enyyaalark/px4-dual-motor-rpm-sync/data/raw/2026-09-03/2026-09-03_ch2_hc14_manual_1nF.png

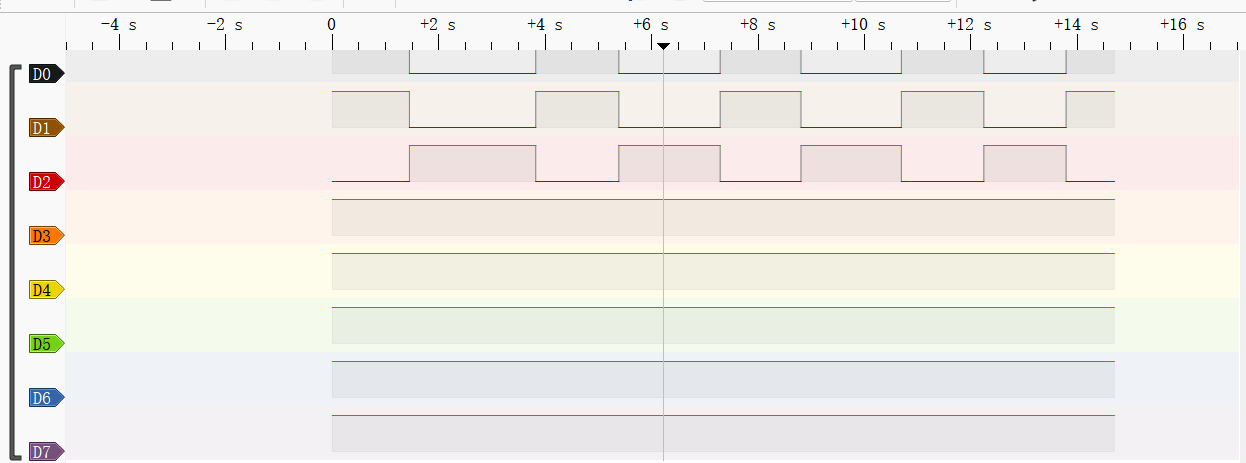
data/raw/2026-09-03/2026-09-03_ch2_hc14_manual_1nF.png
