enyyaalark/px4-dual-motor-rpm-sync/data/raw/2026-09-03/2026-09-03_crosstalk_both_same.png

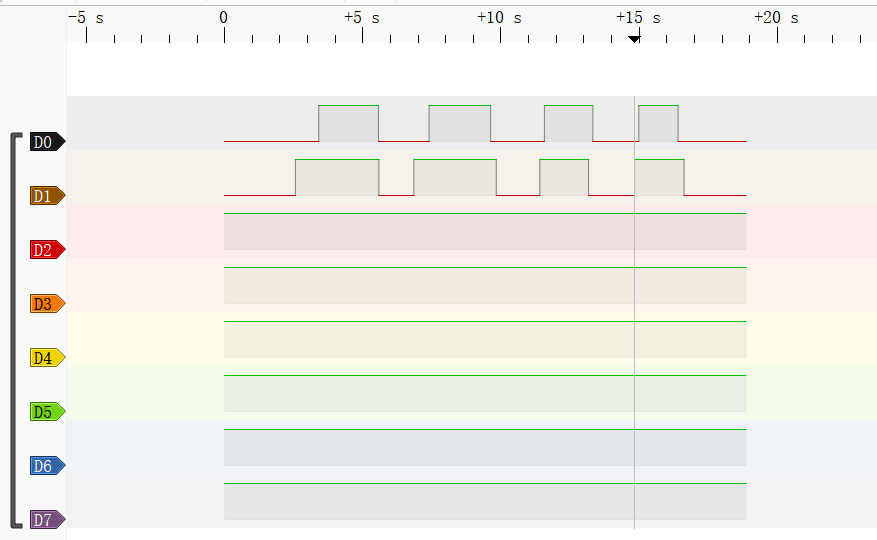
data/raw/2026-09-03/2026-09-03_crosstalk_both_same.png
