enyyaalark/px4-dual-motor-rpm-sync/firmware/stm32/README.md

# STM32G431 固件骨架

此目录包含与硬件无关、可在主机上检查的 C++17 应用层、Issue #3 的最小点灯/UART 工程、Issue #6 的双路霍尔捕获、Issue #9 的双路 PX4 PWM 输入，以及 Issue #10 的 TIM1 双路 PWM 输出。Hall 捕获已实机验证；PWM 输入已实机静态采集；TIM1 输出已通过 CubeMX 重新生成和 Debug/Release 目标构建，但尚未接逻辑分析仪实机验证。旁路和最终整机落针仍未验证，当前工程不能作为最终控制器配置。

`rpm_sync_bringup.ioc` 是 Issue #3 专用的最小点灯/UART 配置，不是最终控制器引脚表。它只使用经 WeAct Studio V1.0 原理图和官方示例确认的板级资源：QFN48 `STM32G431CBU6`、`PC6` 用户 LED、`PA13/PA14` SWD，以及 STM32 数据手册支持的 `PA9/PA10` USART1。后续霍尔、PWM、旁路和 DMA 分配仍保持 `TBD`。

Issue #10 已把双路 PWM 校验通过 `pwm_output_adapter.h` 暴露给生成的 C/HAL 层，并把
实现链接进目标工程。按成员 A 2026-09-14 的配置同步，`rpm_sync_capture.ioc` 现在把
`PA8/TIM1_CH1` 和 `PA10/TIM1_CH3` 配置为 1 MHz（Prescaler 15）、Period 2499（400 Hz）、
PWM mode 1、Active High、ARR/OC preload，初始 Pulse 为 0；`PA10` 不再作为 USART1_RX，
未接线的 `USART1_RX` 移到 `PB7`。`main.c` 提供一个仅逻辑分析仪使用的测试入口，
显式输出约 1000 µs（CH1）和 1080 µs（CH3），不接 ESC/HCT157/电机/电池，闭环保持关闭。

Issue #11 在同一工程中把 `PB2` 配置为 `BYPASS_SELECT` GPIO 输出（push-pull、no pull、
low speed）。`MX_GPIO_Init()` 会先写输出锁存低电平再初始化，确保上电/复位期间不产生
短高脉冲，外部 `10kΩ` 下拉继续保证 STM32 掉电/高阻时 HCT157 选择 PX4 A。测试固件
默认不自动选择 B；`BYPASS_SELECT_TEST_ENABLE` 默认为 `0U`，置 `1` 后才周期切换 PB2。

`rpm_sync_capture.ioc` 在该基线上加入 Issue #6 候选捕获：`PA0/TIM2_CH1` 和 `PA1/TIM2_CH2` 共用 1 MHz、32 位自由运行计数器，双路均为上升沿直接输入、中断捕获。数字滤波暂为 `0`，必须根据 HC14 实际波形和最高预期频率再确定。`hall_capture.c` 的中断路径只记录捕获 tick、周期和毫秒时间戳；主循环快照经 `rpm_evaluator.cpp` 薄适配层交给 C++17 的 `hall_monitor`，每秒通过 PA9 输出一次 `rpm_sync_capture,v2` 遥测，包含两路有效标志、周期（µs）、最后脉冲年龄（ms）、原始/有效 RPM 和状态。

Issue #9 在同一工程中加入 `PB4/TIM3_CH1` 和 `PB6/TIM4_CH1`。每路使用独立的 1 MHz、16 位 PWM-input/reset 定时器：CH1 捕获上升沿周期，CH2 间接捕获下降沿高电平宽度。ISR 只保存固定大小快照；主循环通过 `pwm_input_evaluator.cpp` 判断 950–1950 µs 范围和 10 ms 超时，并另发 `rpm_sync_pwm_input,v1` 诊断行，不改变现有 Hall v2 或 11 字段遥测协议。闭环仍关闭。MAIN1 实机发现 PA6 捕获接触不良，已于 2026-09-15 改为 PB4/TIM3_CH1。

实机接线复核后可做有界采集：`python3 tools/check_pwm_input_uart.py --port <本机串口> --duration-s 30 --required-samples 10 --require-both-valid --output data/raw/<日期>/<新文件名>.txt`。工具只接受新文件名，防止覆盖原始数据。串口设备名和本机绝对路径不得提交。

2026-09-10 的两电机三点标定已把 PPR 确认为 `1` 并更新集中配置。团队随后把
`kHallTimeoutMs=100U` 和 `kMaximumRpm=3300.0F` 接受为 `MONITOR_ONLY` 实机复核所需
的工程初值：前者来自 34.787 ms 最长入选周期，后者在 3000 RPM 台架安全上限之上
保留 10% 判定余量。当前构建因此可产生 `VALID`、`TIMED_OUT` 或
`IMPLAUSIBLE_PULSE`；这不代表停止归零或过速边界已实机验证，也不允许超过
3000 RPM 测试。闭环继续默认关闭，PWM 输出配置仍无效。

2026-09-11 将 `main` 提交 `67e07c3` 的 Release 构建经三线 SWD 写入并校验后，
`rpm_sync_capture,v2` 在 PA0/PA1 双路同时旋转时持续报告 `VALID`，停转后的下一秒
UART 快照起双路均报告 `TIMED_OUT`，且 raw/effective RPM 均为 0。原始记录见
`data/raw/2026-09-11/`。由于遥测周期为 1 秒，该证据不能测量精确的 100 ms 转换时刻；
100/101 ms 软件边界仍由主机测试覆盖。测试指令、电池当次电压和固定细节未写入原始
UART，完整 L2 条件复现仍需补充记录。

接线完成后，可用 `tools/check_hall_capture_uart.py` 做有界采集。工具兼容历史 `v1` 周期记录，并严格检查 `v2` 的 RPM/状态字段、无符号 32 位范围和有效标志；它以独占创建方式保存原始文本，避免覆盖已有证据。例如：`python3 tools/check_hall_capture_uart.py --port <本机串口> --duration-s 15 --required-samples 5 --require-both-valid --output data/raw/<日期>/<新文件名>.txt`。串口设备名只在本地命令中填写，不提交到仓库。

## 计划结构

```text
firmware/stm32/
├── App/                         C++17 应用接口与纯逻辑骨架
├── rpm_sync_bringup.ioc         Issue #3 最小点灯/UART 配置
├── rpm_sync_capture.ioc         Issue #6 双路 Hall 捕获候选配置
├── Inc/                         CubeMX 生成的初始化头文件
├── Src/                         CubeMX 生成的初始化源码和启动心跳
├── Drivers/                     STM32CubeG4 v1.6.3 所需 HAL/CMSIS 子集
├── STM32CubeIDE/                IDE 工程、启动文件和链接脚本
├── README.md
└── hardware_config_template.md
```

## 集成原则

1. 先在独立最小工程验证点灯、UART、双路捕获。
2. CubeMX 生成的 HAL/Core 可以保留 C；在薄的 `.cpp` 适配层中实现回调，必要时用 `extern "C"` 导出 HAL 要求的符号。
3. HAL 回调只采集时间戳/数据，计算和控制放在周期任务。
4. 所有引脚、定时器实例和 DMA 通道放在板级配置层，不写入通用模块。
5. `app_config.hpp` 中的默认值不会启用闭环；PPR、增益和超时必须标定。
6. 每个模块通过逻辑分析仪/主机测试独立验收后再集成。

主机语法检查：

```bash
c++ -std=c++17 -Wall -Wextra -Werror -fsyntax-only firmware/stm32/App/*.cpp
```

此命令不等同于 arm-none-eabi-g++ 交叉编译或 STM32 实机测试。嵌入式构建建议关闭 RTTI 和异常，但需在生成工程后通过尺寸与行为验证再固定编译选项。

## 点灯与 UART 启动前检查

先检查 CubeMX、CubeIDE、交叉编译器、下载器和调试器是否可发现：

```bash
python3 tools/check_stm32_toolchain.py
```

脚本会同时检查 `PATH` 和 STM32CubeIDE 的标准 Linux 安装目录。默认不打印本机绝对路径；`--show-paths` 只用于本地诊断，输出不得复制到仓库、Issue 或测试记录。

当前最小工程固定使用：

- WeAct Studio STM32G431 QFN48 V1.0、`STM32G431CBU6`；
- HSI 16 MHz、`PC6` 状态灯、`PA9/USART1_TX`、115200 8N1；
- STM32CubeMX 6.18.1、STM32CubeG4 v1.6.3、STM32CubeIDE 工程；
- 每 500 ms 翻转 LED，每 1 s 发送 `rpm_sync_bringup,v1,...,mode=MONITOR_ONLY`。

在 STM32CubeIDE 中导入 `firmware/stm32/STM32CubeIDE`。重新生成前必须安装 STM32CubeG4 v1.6.3，并选择只复制所需库文件；不得把本机固件包绝对路径写入 `.ioc`。

`Debug` 和 `Release` 两个 configuration 均已启用 `convertbinary`，构建后除 `.elf` 还产出 `.bin`。USB DFU 下载只接受 `.bin`，因此该选项不能关闭；`tests/test_stm32_bringup_config.py` 对此有回归测试，防止重新生成工程时被覆盖。DFU 下载使用 `Release/rpm_sync_bringup.bin`。

无图形界面时可用 headless 构建：

```bash
/path/to/stm32cubeide/headless-build.sh -data <临时工作区> \
  -importAll firmware/stm32/STM32CubeIDE -cleanBuild all
```

临时工作区不要放在仓库内。`Debug/`、`Release/`、`*.elf`、`*.bin` 已被 `.gitignore` 覆盖。

UART 仅允许单向连接：核心板 `PA9` 接 CH340 模块 `RXD`，两者 `GND` 相连。已测得 CH340 `TXD` 空闲电平约 5 V，因此 `TXD`、`5V`、`3V3`、`RTS`、`CTS` 均不得连接核心板。

本实板已于 2026-09-01 确认可通过核心板 USB-C 进入 STM32 ROM DFU，并使用 STM32CubeProgrammer 完成固件写入和校验。PC6 LED 的 500 ms 翻转已通过复位启动及 USB-C 断电重启观察。PA9 单向 UART 首次采集和 USB-C 断电约 5 秒后的第二次采集均获得至少 3 条完整、格式匹配的心跳；另外 30 秒连续采集获得 10/10 条有效心跳。Issue #48 于 2026-09-04 完成三线 SWD 只读验证：两次目标识别结果一致，断开 ST-LINK 后原点灯固件正常恢复；未执行擦除、下载或选项字节修改。2026-09-04 进一步经 ST-LINK 三线 SWD 下载并校验双路捕获固件（`Release/rpm_sync_bringup.bin`，SHA256 `c1ac5a01951ab47918bd1fad62f2dbb64dbaeb6adb38390f1267d37d5af36c98`），随后通过 UART 记录无脉冲、Hall 1、Hall 2 与复位后双路捕获；原始记录见 `data/raw/2026-09-04/`。`chN_valid` 是历史捕获标志，`chN_age_ms` 变化才表示新脉冲。

点灯与 UART 属于 L1 测试：电机主电源必须断开，螺旋桨必须拆除，并避免 USB、ST-LINK 和外部电源之间反灌。
