enyyaalark/px4-dual-motor-rpm-sync/docs/control-algorithm.md

# 控制算法

## PWM 输入有效性

输入捕获/中断层只记录最新原始脉宽、更新时间和“已有样本”标志。范围判断和超时判断在周期任务使用一致的数据快照完成，不在捕获路径写死尚未测量的 PX4 输入参数。

`pwm_input` 的纯逻辑接口由调用方提供最小脉宽、最大脉宽和超时。2026-09-11 已测得 PX4 MAIN1/2 为 400 Hz，静态 1000 µs、测试指令 1300 µs，配置端点为 disarmed 1000 µs、active 1100–1900 µs。因此 `app_config.hpp` 采用 950–1950 µs 监测窗口和 10 ms 超时（约四个丢失帧）作为 `MONITOR_ONLY` 实机验证初值。它不启用闭环，也不替代 STM32 实机捕获、PWM 电平和 ESC 范围验证。状态包括：

- `kWaitingForSample`：尚未捕获输入，有效脉宽为 0；
- `kValid`：样本未超时且位于调用方提供的闭区间内；
- `kTimedOut`：样本已过期，有效脉宽为 0；
- `kOutOfRange`：原始脉宽越界，有效脉宽为 0，但保留原始值供诊断；
- `kInvalidConfig`：最小值为 0、最小值大于最大值或超时为 0，拒绝输出。

毫秒时间使用无符号 32 位差值，可处理两次检查间最多一次回绕。主机测试证明状态语义，不证明 STM32 捕获精度或信号电平；若实机结果不满足当前窗口或超时，必须根据原始证据重新评审参数。

## PWM 输出有效性与最终限幅

`pwm_output` 的硬件无关接口同时接收两路浮点脉宽请求和调用方提供的最小/最大输出边界。当前 `app_config.hpp` 使用成员 A 2026-09-15 v2 台架范围 `1060–1080µs`；该范围仅用于无桨双电机 RPM 同步验证，不得用于飞行或带桨测试。

- 有限请求在闭区间内取到最近的整数微秒；超出边界时饱和到最近边界，并单独报告每路是否发生限幅；
- 最小值为 0 或最小值大于最大值时返回 `kInvalidConfig`；
- 任一路请求为 NaN 或无穷值时返回 `kInvalidRequest`，整组两路输出均不可用，避免只更新一侧；
- 返回状态不是 `kValid` 时，两路有效脉宽保持 0。未来 HAL 适配层必须检查状态并保持定时器输出未启用，不能把 0 当作已验证的 ESC 指令。

该接口只验证数值边界，不产生波形。输出频率、计数器换算、同步更新、启动/复位瞬态和真实限幅仍需逻辑分析仪完成 T07。

## RPM 计算

```text
RPM = 60 * pulse_frequency_hz / pulses_per_revolution
```

`pulses_per_revolution` 必须用激光转速计或其他独立方法标定，不根据磁极数量猜测。停止超时后 RPM 必须归零。

建议同时保留原始周期、瞬时 RPM 和经明确时间常数滤波后的控制 RPM。滤波不能掩盖脉冲丢失。

### 硬件无关计算状态

`rpm_capture` 用无符号 32 位减法计算相邻捕获值的差，可处理相邻脉冲之间最多一次计时器回绕。首个脉冲只建立基准，不产生周期或 RPM；脉冲时间戳是否存在由独立布尔状态表示，因此系统启动后 `now_ms == 0` 仍是合法时间。

`hall_monitor` 的纯逻辑接口由调用方传入计时器频率、PPR、停止超时和最大合理 RPM。
PPR 已于 2026-09-10 标定为 1；团队同时接受 `100 ms` 停止超时和 `3300 RPM` 最大
合理值作为 `MONITOR_ONLY` 复核初值。100 ms 来自 34.787 ms 最长入选周期，3300 RPM
是在 3000 RPM 硬件测试安全上限之上的 10% 异常判定余量；两者尚未实机验证，且
3300 RPM 不提高台架许可转速。任一必需参数为零值、负值、NaN 或无穷值都属于无效
配置，不能输出有效 RPM。计算结果分为：

- `kWaitingForPeriod`：尚无两个脉冲，有效 RPM 为 0；
- `kValid`：原始 RPM 在调用方提供的合理范围内，可用 RPM 等于原始 RPM；
- `kTimedOut`：最后脉冲超过调用方提供的超时，有效 RPM 和原始 RPM 均为 0；
- `kInvalidConfig`：PPR 等配置无效，拒绝输出；
- `kImplausiblePulse`：周期为零、计算失败或超过调用方提供的最大 RPM，有效 RPM 为 0；若公式可计算则保留 `raw_rpm` 供诊断。

Issue #7 已通过 C/C++ 薄适配层把这些状态接入双路 HAL 捕获快照和版本化 UART 遥测，但尚未接入最终故障标志或控制状态机。当前最大 RPM 与停止超时只是团队接受的待验证初值；脉冲跳变阈值、停止归零和双路行为仍必须用实测波形/UART 确认，主机测试不能代替该验证。

`system_controller` 已把上述模块组合成硬件无关周期步骤：MAIN1/MAIN2 两路基础 PWM 均有效、脉宽差不超过 `kBasePwmMismatchUs=20µs`、且两路都不低于台架输出下界 `1060µs` 时，才允许产生修正输出并选择 STM32 路径；任一输入等待、越界、单路超时、两路不一致或 disarm 基础值低于 1060µs 时继续选择 PX4 原始旁路。非同步状态只透传基础指令，`SYNC_CONTROL` 才施加受限修正。故障刷新目前使用非锁存活动故障；安全关键故障是否锁存以及 `kOutputSaturated` 的门控语义仍待故障注入实验后确定。

## 误差

第一阶段仅在 `base_pwm1 == base_pwm2`（允许小容差）时验证同步：

```text
error_rpm = rpm1 - rpm2
mean_rpm = (rpm1 + rpm2) / 2
error_percent = abs(error_rpm) / mean_rpm * 100
```

`mean_rpm` 过低时不计算百分比并禁止闭环，防止除零和低速噪声放大。

## P/可选 PI/可选滤波微分控制

```text
raw_error = rpm1 - rpm2
if raw_error > deadband_rpm:
    error = raw_error - deadband_rpm
elif raw_error < -deadband_rpm:
    error = raw_error + deadband_rpm
else:
    error = 0

filtered_error = lowpass(error, tau)         # tau <= 0 时跳过滤波
derivative = (filtered_error - previous_filtered_error) / dt

integral = clamp(integral + error * dt, integral_min, integral_max)
correction = clamp(Kp * filtered_error + Ki * integral + Kd * derivative,
                   -correction_limit_us, correction_limit_us)

pwm1 = clamp(base_pwm - correction, pwm_min_us, pwm_max_us)
pwm2 = clamp(base_pwm + correction, pwm_min_us, pwm_max_us)
```

- 死区使用“偏移补偿”而不是硬清零：越过边界后按 `raw_error - deadband_rpm` 计算，使输出在死区边界连续，减少边界抖振和过冲。
- 误差进入死区时清除滤波与积分状态，避免残留偏置把输出继续推过目标；误差换向时用当前误差重置滤波并抑制首拍微分冲击。
- 新增可选的一阶误差低通 `filter_tau_seconds` 和微分增益 `Kd`。`Kd=0` 且 `filter_tau_seconds<=0` 时退化为原有 P/PI 行为。
- 微分基于滤波后的误差做后向差分，并在首次有效采样时不输出微分项，避免使能瞬间的微分冲击。
- 当前拆桨台架参数为 `Kp=0.01`、`Ki=0`、`Kd=0.002`、`filter_tau_seconds=0.1`。本地 A/B 记录显示误差下降，但 baseline 仍含 UART 损坏字节，参数继续视为实验值，不代表飞行配置或最终标定结果；闭环使能策略仍默认关闭。
- P 控制先行；只有开环基线和 P 控制数据表明存在稳定残差且无振荡时才启用 `Ki`。条件积分抗饱和逻辑保持不变，输出饱和且误差同向时冻结积分。

## 必需保护

- 修正量限制：初值不超过基础指令跨度约 5%，最终依数据调整。
- 最终 PWM 限幅：软件测试使用 1000–2000µs synthetic 向量；项目默认值保持无效，必须用实际电调校准替换后才可启用。
- RPM 死区和低速闭环禁止。
- 积分限幅；输出饱和或故障时冻结/回退积分。
- 霍尔脉冲超时、非物理跳变和双路不一致检测。
- PX4 PWM 丢失、越界或两个基础目标不一致时停止“等转速”同步。
- 任一电机疑似失效时不得通过不断抬高另一侧/故障侧输出追赶。
- 故障时清零修正，转入 `BYPASS` 或经评审的安全状态。

## 参数调整顺序

1. `Ki = 0`、修正限幅很小，记录开环数据。
2. 从低 `Kp` 开始阶梯增加，每次只改一个参数。
3. 检查稳态误差、1–2秒恢复目标、振荡、修正饱和和温升。
4. 只有 P 控制结果可重复后评估 PI。
5. 每次参数变更记录固件提交、测试条件和 CSV。

## 差动推力兼容

未来若 PX4 给出不同基础指令，控制目标必须保留上层要求的目标差值；第一阶段直接退出同步控制，而不是强制两侧 RPM 相等。
