enyyaalark/px4-dual-motor-rpm-sync/docs/pin-map.md

# 引脚映射（Issue #6 捕获 L1 UART 采集已验证，整机方案仍待验证）

Issue #6 的候选方案已通过成员 A 的 L0 排针可及性复核和 STM32CubeMX 6.18.1 生成检查。双路 Hall、双路 PX4 PWM 输入与双路 TIM1 PWM 输出配置已落入 `rpm_sync_capture.ioc`；PWM 输入已实机静态采集，PWM 输出仅通过 CubeMX 生成与 Debug/Release 目标构建、尚未接逻辑分析仪实机验证，旁路及最终整机落针仍须各自完成电气和实机验证，因此本表不代表完整控制器已经定版。

| 功能 | 方向 | 外部信号 | STM32 定时器/GPIO | 电气要求 | 状态 |
|---|---|---|---|---|---|
| Hall 1 capture | 输入 | 第一颗 HC14 `1Y` | `PA0 / AF1 / TIM2_CH1` | 3.3 V 整形输出；上升沿捕获 | L0 可及性、CubeMX、物理接线与 UART 采集已验证；最高实际频率待 Issue #8 验证 |
| Hall 2 capture | 输入 | 第二颗 HC14 `1Y` | `PA1 / AF1 / TIM2_CH2` | 3.3 V 整形输出；上升沿捕获 | L0 可及性、CubeMX、物理接线与 UART 采集已验证；最高实际频率待 Issue #8 验证 |
| PX4 PWM 1 | 输入 | Pixhawk MAIN1（左侧后推电机基础指令） | 已配置 `PB4 / AF2 / TIM3_CH1` | 400 Hz；监测范围 950–1950 µs；电平待测 | CubeMX/目标构建通过；实机双路捕获已通过 |
| PX4 PWM 2 | 输入 | Pixhawk MAIN2（右侧后推电机基础指令） | 已配置 `PB6 / AF2 / TIM4_CH1` | 400 Hz；监测范围 950–1950 µs；电平待测 | CubeMX/目标构建通过；排针与实机捕获待复核 |
| ESC PWM 1 | 输出 | HCT157 B1 | 已配置 `PA8 / AF6 / TIM1_CH1` | 400 Hz；当前无桨台架范围 1060–1080 µs | 待实机波形、电平和 HCT157/ESC 边界复核 |
| ESC PWM 2 | 输出 | HCT157 B2 | 已配置 `PA10 / AF6 / TIM1_CH3` | 400 Hz；当前无桨台架范围 1060–1080 µs | 待实机波形、电平和 HCT157/ESC 边界复核 |
| Bypass select | 输出 | HCT157 S | 已配置 `PB2 / GPIO / BYPASS_SELECT` | push-pull、no pull、low speed，初始低电平；外部 10kΩ 下拉 | 需逻辑分析仪验证上电/复位低电平与 B 选择 |
| Telemetry TX | 输出 | CH340 RXD（第一阶段） | `PA9 / USART1_TX` | 3.3V UART；仅单向连接 | Issue #3 bring-up 已实板验证，最终控制器待复核 |
| Telemetry RX | 输入 | 第一阶段不连接 | 已配置 `PB7 / AF7 / USART1_RX`（仅满足 CubeMX Asynchronous 模式，不接线） | CH340 TXD 实测 5 V，禁止直连 | 最终控制器只发不收；bring-up `.ioc` 保持原样 |
| Status LED | 输出 | 板载蓝色 LED | `PC6` | WeAct QFN48 V1.0，低速推挽输出 | Issue #3 bring-up 已确认 |

## 定时器资源与理由

| 定时器 | 候选用途 | 计数方案 | 设计理由 | 未验证项 |
|---|---|---|---|---|
| `TIM2` | Hall 1/2 上升沿捕获 | CubeMX 配置为 1 MHz 自由运行、32 位递增计数 | 两路共享同一时间基准；1 µs/tick 时约 71.6 分钟回绕，应用层按无符号 32 位差值处理单次回绕 | 实机 tick/波形对照、输入滤波、最大脉冲频率和中断负载 |
| `TIM3` | PX4 PWM 1 测量 | 已配置 1 MHz；PWM input/reset mode | 每路 PWM 独占一个定时器，避免两路信号争用同一 slave-reset 时间基准 | STM32 实机周期/脉宽、丢失和越界行为 |
| `TIM4` | PX4 PWM 2 测量 | 与 TIM3 相同 | 与 MAIN1 独立测量，可分别检测超时和越界 | 同上 |
| `TIM1` | ESC PWM 1/2 输出 | 已配置 1 MHz、Prescaler 15、Period 2499（400 Hz）；CH1/CH3 PWM mode 1、OC preload、ARR preload | 两路共享周期计数器并同步更新；当前无桨台架范围 1060–1080 µs | 启动/复位瞬态、输出电平、频率、脉宽和 HCT157 波形 |

## Issue #6 实际 Hall 接线

成员 A 于 2026-09-03 更正确认：两路分别使用两颗独立 SN74HC14N 的第一组门，而不是在同一颗芯片上使用 `1A/1Y` 和 `2A/2Y`。

```text
第一颗 SN74HC14N：1A 接第一路 RC 输出，1Y -> PA0/TIM2_CH1
第二颗 SN74HC14N：1A 接第二路 RC 输出，1Y -> PA1/TIM2_CH2
```

两颗芯片的独立 RC 网络、3.3 V 供电、100 nF 退耦和共地已由成员 A 复核。门编号变化不改变 STM32 引脚或固件通道映射；双路捕获已通过 SWD 下载固件与 UART 采集验证。项目负责人取消单独的手动周期对照，最高预期频率与滤波结论转交 Issue #8。

`PA11/PA12` 保留给板载 USB/ROM DFU 路径，不用于控制输出；`PA13/PA14` 始终保留 SWD；`PA9` 保留单向遥测；`PC6` 保留状态灯。`PA10` 已改为 `TIM1_CH3`，未接线的 `USART1_RX` 移到 `PB7` 以保持 CubeMX Asynchronous 模式。这不授权连接 CH340 TXD 或任何 RX 线路。

## HAL 捕获边界

1. `HAL_TIM_IC_CaptureCallback` 或等效 IRQ 适配层只读取捕获寄存器、记录通道和时间戳，并调用有界的脉冲采集入口；不在中断中计算 RPM、判断故障、格式化 CSV 或发送 UART。
2. Hall 两通道读取同一 `TIM2` 32 位计数域；不得用毫秒系统时钟代替捕获 tick。应用层周期任务再调用 `evaluateRpm` 处理超时、异常和归零。
3. PX4 PWM 每路使用独立定时器测量周期和高电平宽度；根据 2026-09-11 的 400 Hz 波形，输入采用上升沿、无数字滤波、10 ms 监测超时。该初值只用于 `MONITOR_ONLY` 实机复核，实测失败时必须回退并重新评审。
4. 捕获数据从 IRQ 交给周期任务时必须使用固定大小快照和明确的临界区/原子策略；不得动态分配、阻塞或使用无界队列。
5. 首轮实机验证只允许 L1 手动脉冲或已复核的逻辑信号。电机主电源断开、螺旋桨拆除；逻辑分析仪物理接线和原始波形采集由成员 A 完成。

## 复核依据

- STMicroelectronics [`DS12589 Rev 6`](https://www.st.com/resource/en/datasheet/stm32g431cb.pdf)，STM32G431x6/x8/xB 数据手册 Table 12/13：封装引脚和 alternate function。
- STMicroelectronics [`RM0440 Rev 9`](https://www.st.com/resource/en/reference_manual/dm00355726.pdf)：`TIM2` 为 32 位通用定时器，`TIM3/TIM4` 为 16 位通用定时器；输入捕获、PWM input 和 preload/update 行为以该手册为准。
- WeAct Studio [`WeActStudio.STM32G431CoreBoard`](https://github.com/WeActStudio/WeActStudio.STM32G431CoreBoard) 官方仓库的 QFN48 V1.0 原理图：候选 GPIO 已引出到两侧排针；最终仍须成员 A 对实板丝印和可及性复核。

## 分配准则

1. 两路霍尔使用同一个 32 位自由运行时间基准，以保证跨通道周期差可直接比较。
2. 两路 PX4 PWM 捕获和两路 ESC PWM 输出避免通道/复用冲突。
3. 确认引脚为 3.3V 容限、上电状态安全且不占用 SWD。
4. 记录 CubeMX 版本、时钟树、计数频率和溢出处理策略。
5. 分配完成后由另一名成员对照原理图、数据手册和核心板丝印复核。

第一阶段固定使用 `MAIN1 -> 左侧后推电机`、`MAIN2 -> 右侧后推电机`，并只验证两路基础指令相同的同步。这里的编号从机体向前观察，以机体左/右为准；它只是逻辑通道基线。在确认 Pixhawk 硬件修订、输出电平、连接器方向并完成无动力波形验证前，不得据此连接 ESC。
