enyyaalark/px4-dual-motor-rpm-sync/docs/open-questions.md

# 待确认问题

未知项不得在代码或接线中猜测。确认后应附数据手册/测量证据，并同步更新相关文档。

| ID | 待确认项 | 为什么重要 | 负责人建议 | 阻塞内容 |
|---|---|---|---|---|
| Q01 | 飞控外壳已确认 `Pixhawk 6C Mini`；制造商和 Model A/B/legacy 硬件修订仍待确认 | 修订决定 PWM 电压选择位置和部分硬件能力 | role:hardware | PWM 电平确认与最终接线 |
| Q02 | PX4 已更新为 1.17.0（提交 `d6f12ad1c4f70ad3230afd7d86e971421e02fef4`）；`SYS_AUTOSTART=2100`、`SYS_HITL=0`、MAIN1/2=Motor1/2，但双发几何和最终飞行配置仍未验收 | 参数名、输出协议和行为必须绑定精确版本；台架通道成立不等于飞行配置安全 | role:firmware | 最终 PX4 配置与飞行前评审 |
| Q03 | 接收机已确认 FlySky `FS-SR8`（用户 2026-09-02 确认；旧照片识读 FS-iA10B 有误），厂家资料为 2.4GHz ANT 协议、输出可选 PWM/PPM/i-BUS/s-BUS；当前实际输出模式仍待确认（不能由型号推断） | 决定 PX4 输入配置 | role:hardware | 遥控全链路 |
| Q04 | 两只 ESC 已确认为相同的 Flycolor `Raptor5 G071-35A`，固件标识均为 `Flycolor_Raptor_5`（用户确认）；固件版本号、配置、3.3V 接受度和失联行为仍待确认 | 决定 PWM 范围、刷新率和安全行为 | role:hardware | PWM 输出/安全 |
| Q05 | 电池已确认为 3S1P，用户确认额定 11.1V、4000mAh、100C；化学体系、满充/当前实测电压、连接器和线规仍待确认 | 容量与 C 倍率共同决定理论电流；实测电压和连接决定动力风险与降压设计 | role:hardware | 带电机测试 |
| Q06 | 螺旋桨尺寸与旋向 | 决定负载和机械安全 | role:hardware | 带桨测试 |
| Q07 | Hall 捕获 `PA0/PA1 + TIM2_CH1/CH2` 已实机验证；PWM 输入 `PB4/TIM3_CH1 + PB6/TIM4_CH1` 已实机双路采集；TIM1 双路 PWM 输出 `PA8/TIM1_CH1 + PA10/TIM1_CH3` 已通过逻辑分析仪实机验证；旁路选择 `PB2/GPIO` 已配置为初始低电平、仅逻辑分析仪测试入口可切换。HCT157 旁路及最终整机资源仍待验证 | 决定完整 CubeMX 工程与布线 | role:firmware | HCT157 旁路与整机集成 |
| Q08 | 独立激光转速计型号/可用性 | PPR 和 3% 误差目标需要参考 | 两人共同 | M1 标定 |
| Q09 | HCT157/HC14 实物厂商与供电方案 | 电平阈值和绝对额定值必须按数据手册确认 | role:hardware | 逻辑电路上电 |
| Q10 | 刚性台架、防护罩和急停方案 | 带桨测试的前置安全条件 | 两人共同 | M3 带桨测试 |
| Q11 | CH340 USB-TTL 到 STM32 的电平转换方案 | 当前 TXD 空闲高电平实测为 5V，不能直连 STM32；T01 仅使用 STM32 TX 到 CH340 RX 的单向链路 | role:hardware | 双向 UART 或任何 CH340 TX 接入 |
| Q12 | 中央 `DIO/CLK/GND` SWD 排针及三线调试链路已验证 | 两侧 I/O 排针和中央 SWD 排针均已组装；两次只读 SWD 识别结果一致，断开后原点灯固件恢复正常 | 已确认 | 不再阻塞 SWD 调试；其他 I/O 仍需按最终引脚表逐项复核 |

## 决策记录模板

```text
问题 ID：
结论：
依据（数据手册/测量/照片）：
确认日期：
复核人：
受影响文件：
```

## 2026-09-01 部分确认记录

- Q01：用户确认现有临时照片展示飞控底面，可读到 `pixhawk 6c mini` 和 MAIN/AUX/RC IN 端口编号；但该底面没有可读的制造商、Model A/B/legacy 修订或 PWM 电压焊盘状态。Holybro 同型号资料显示 PWM 输出可能随硬件修订/焊盘配置为 3.3V 或 5V，因此在获得其他修订证据并实测前，不关闭电平相关问题。
- Q03：临时照片可读到 FlySky `FS-iA10B`；厂家规格列出 AFHDS 2A、10 路 PWM，以及 PWM/PPM/i.bus/s.bus 数据接口。照片不证明当前接收机配置。（2026-09-02 更正为 FS-SR8，见下方记录。）
- Q04：临时照片可读到 Flycolor Raptor 5、35A、3–6S；厂家产品页对应 `Raptor5 G071-35A`，厂家手册列出 35A 持续、40A/10秒、无 BEC、3–6S，并支持普通 1–2ms PWM。用户后续确认第二只 ESC 同型号；两只实际固件、配置和输入电平阈值仍需实物/测量证据。
- 临时照片文件名和厂家链接记录在 `docs/hardware-overview.md`；`Pictures/` 不进入版本控制。
- Q02：仅 USB 供电条件下通过 MAVLink 读取 PX4 v1.12.3；同时发现 `SYS_AUTOSTART=1001`、`SYS_HITL=0`、MAIN 1–4/400Hz/1075–1950us。用户已确认台架逻辑映射为 `MAIN1 -> 左侧后推`、`MAIN2 -> 右侧后推`，两路使用相同基础指令；但 PX4 v1.12 文档将 1001 定义为 HIL Quadcopter X，因此通道映射不解除动力测试阻塞。完整只读记录见 `docs/hardware-overview.md`。
- Q02（2026-09-11 当前基线）：NSH `ver all` 确认 PX4 1.17.0、提交 `d6f12ad1c4f70ad3230afd7d86e971421e02fef4`；`SYS_AUTOSTART=2100`、`SYS_HITL=0`、MAIN1/2 功能 101/102、400 Hz、disarmed 1000 µs、active 1100–1900 µs。成员 A 在 USB-only 条件下用逻辑分析仪确认双路 400 Hz/1000 µs，并分别通过 `actuator_test` 观察到目标通道 1300 µs、另一通道保持 1000 µs及约 500 ms ramp。该证据确认 Issue #9 的台架输入，不确认 PWM 电压或最终飞行几何。
- Q04/Q05/布局：用户确认验证结构为双发后推布局，两只 ESC 同型号，并提供电池 3S1P、11.1V、100C 信息。未提供容量，故不能计算 100C 对应的理论电流；动力测试继续等待电池标签/实测与电气复核。（2026-09-02 用户补充确认容量 4000mAh，见下方记录。）

## 2026-09-02 确认/更正记录

- Q03（更正）：用户确认接收机一直为 FlySky `FS-SR8`，2026-09-01 依照片识读的 `FS-iA10B` 是错误识别。厂家官方资料（产品页与 FS-SR8 用户手册）：2.4GHz ANT 协议、8 通道 PWM、双天线、供电 3.5–9V、输出可选 PWM/PPM/i-BUS/s-BUS。遥控器（发射机）型号、接收机当前输出模式与输出电平仍待确认，不能由型号推断。复核：成员 B（PR #51 评审）。
- Q04：用户确认两只 Raptor5 G071-35A ESC 的固件标识均为 `Flycolor_Raptor_5`；固件版本号、配置参数、3.3V 控制电平接受度和失联行为仍需实物/测量证据。复核：成员 B（PR #51 评审）。
- Q05：用户补充确认电池容量 4000mAh，额定信息完整为 3S1P、11.1V、4000mAh、100C；化学体系、满充/当前实测电压、连接器和线规保持 `TBD`，等待电池标签照片与实测。复核：成员 B（PR #51 评审）。
- 上述确认记录于 PR #51 评审意见及 Issue #1/#2 评论；基线同步更新至 README、`docs/hardware-overview.md`、`docs/bill-of-materials.md`、`docs/open-questions.md`、`docs/voltage-interface-table.md` 与 CHANGELOG。

## 2026-09-03 确认记录

- Q12：用户确认核心板中央 `DIO/CLK/GND` SWD 排针已经焊接。成员 A 随后完成三线对应、无短路、单一供电与外围隔离复核；成员 B 于 2026-09-04 使用 STM32CubeProgrammer v2.23.0 连续两次只读识别到 3.27 V、Device ID `0x468`、STM32G43x/G44x、128 KBytes NVM 和 Cortex-M4。断电拆除 SWD 三线后，仅恢复 USB-C 供电，用户观察 PC6 点灯固件正常运行。未执行擦除、下载或选项字节修改，未记录探针序列号或芯片 UID；证据见 Issue #48。

## 2026-09-04 确认记录

- Q07/Q12：成员 B 于 2026-09-04 经 ST-LINK 三线 SWD 下载并校验双路捕获固件，随后通过 PA9 单向 UART 记录无脉冲、Hall 1、Hall 2 与复位后双路捕获，两路 `chN_valid` 均置位且周期非零。原始记录见 `data/raw/2026-09-04/`。项目负责人随后取消单独的手动周期对照并按修订范围关闭 Issue #6；PPR 标定、最高预期频率与数字滤波结论转交 Issue #8。
