enyyaalark/px4-dual-motor-rpm-sync/docs/voltage-interface-table.md

# 电压接口表

> 建立日期：2026-08-31
> 状态：A3144E→HC14 双路 L1 手动触发、串扰与线束稳定性验证已完成（独立第二颗 SN74HC14N 1A/1Y；限于 20 kHz 采样率、50 µs 时间分辨率与现有捕获窗口；1nF 保留为起始值）；STM32 定时器捕获已通过 SWD 下载固件与 UART 双路采集验证。单独的手动周期对照已取消，RPM 与最高预期脉冲频率验收转交 Issue #8
> 原则：未确认项保持 `TBD`，不猜测；每项确认都要附数据手册、照片或测量证据

## 表格

| 接口 | 发送端 | 发送端电平/协议 | 接收端 | 接收端要求 | 实测值 | 状态 | 证据 |
|---|---|---|---|---|---|---|---|
| PX4 -> STM32 PWM 输入 | Pixhawk 6C Mini，PX4 1.17.0（提交 `d6f12ad1c4f70ad3230afd7d86e971421e02fef4`） | 400 Hz 标准 PWM；信号电压可硬件切换 3.3V/5V | STM32G431 PB4/TIM3_CH1、PB6/TIM4_CH1 | 3.3V 容限 | 静态 1000 µs、动态 1300 µs，约 ±1 µs；电压 `TBD` | 时序/通道已测，电平和 STM32 实机捕获待确认 | Issue #9 NSH 与逻辑分析仪评论 |
| STM32 -> HCT157 | STM32G431 PWM 输出 | 3.3V PWM | SN74HCT157N B1/B2 | 输入高电平阈值按数据手册 | `TBD` | 待测 | 数据手册/逻辑波形 |
| HCT157 -> ESC | SN74HCT157N Y1/Y2 | 标准 PWM，暂定 1000–2000µs | Raptor 5 ESC，固件 `Flycolor_Raptor_5` | 支持常规 1–2ms PWM；3.3V 控制电平待实测 | `TBD` | 型号已确认，3.3V 接受度待实测 | Flycolor 说明书/实测 |
| A3144E -> HC14 | A3144E OUT，开集电极 | VCC 5.06V；OUT 经 4.7kΩ 上拉至 3.3V，1kΩ 串联，1nF 起始滤波 | SN74HC14N 施密特输入 | 施密特输入，3.3V 逻辑 | 无磁体：OUT 3.26V、1A 3.26V、1Y 0V；2 颗磁铁约 7mm 触发，单次边沿干净 | L1 手动触发实测通过 | 2026-09-02 波形与原始采集（`data/raw/2026-09-02/`，含 `.sr`）、万用表记录 |
| HC14 -> STM32 霍尔捕获 | SN74HC14N #1 `1Y` / 独立 #2 `1Y` | 3.3V 整形方波（反相） | STM32 TIM2 输入捕获候选 `PA0/PA1` | 定时器输入捕获能力 | 无磁体 0V，触发时约 3.2V；UART 双路捕获周期非零 | 输出端、接线与 UART 采集已验证；最高频率与数字滤波结论待 Issue #8 | 2026-09-02/03 波形（`data/raw/2026-09-02/`、`data/raw/2026-09-03/`，含 `.sr`）、2026-09-04 UART 原始记录（`data/raw/2026-09-04/`） |
| STM32 UART -> PC/PX4 | STM32G431 TX | 3.3V UART，波特率 `TBD` | USB-TTL RX / PX4 RX | RX 电平匹配 | `TBD` | 待测 | 串口记录 |
| 接收机 -> PX4 遥控输入 | FLYSKY FS-SR8（用户确认；2026-09-01 照片识读的 FS-iA10B 有误） | 2.4GHz ANT 协议；输出可选 PWM/PPM/i-BUS/s-BUS（厂家资料） | Pixhawk 6C Mini RC 输入 | 待确认实际输出模式；不能由型号推断 | `TBD` | 型号与协议能力已确认，实际输出模式待定 | FlySky 官方产品页/FS-SR8 手册（见参考来源） |
| 电池 -> ESC 主电源 | 3S1P 电池（用户确认 4000mAh），标称 11.1V，化学体系 `TBD` | 标称 11.1V 电压 | Raptor 5 ESC | 支持 3–6S | `TBD` | 电池额定信息已确认（用户），实际电压/连接待测 | 用户确认记录（PR #51 评审/Issue #1）、Flycolor 说明书 |
| 电池 -> 降压模块 -> 逻辑电源 | 电池，规格已记录 | 11.1V 标称电压 | 降压模块，型号 `TBD` | 输入额定范围 | `TBD` | `TBD` | 数据手册/万用表 |
| 降压模块 -> 逻辑电路 | 降压模块输出，型号 `TBD` | 输出电压 `TBD`，额定电流 `TBD` | STM32/HC14/HCT157 供电 | 3.3V 逻辑电源，纹波 `TBD` | `TBD` | `TBD` | 数据手册/万用表 |
| L1 逻辑电源（临时台面） | WeAct 板 3.3V / USB-TTL 5V | 3.26V / 5.06V | HC14/A3144E 供电 | 3.3V 逻辑、霍尔 5V | 3.26V / 5.06V | 实测通过，仅限 L1 临时电源，非最终降压方案 | 万用表记录 2026-09-02 |
| 共地 | PX4、STM32、HC14、HCT157、ESC 信号地 | GND | 所有控制信号共同参考地 | 共地 | L1 台面：WeAct、USB-TTL、HC14 共地已验证；PX4/ESC 共地待后续 | 部分验证 | 万用表/L1 接线记录 |

## 当前已从仓库确认的信息

- A3144E 输出为开集电极，按设计使用 `4.7kΩ` 上拉至 3.3V，`1kΩ` 串联，`1nF` 起始滤波，再进入 SN74HC14N。
- STM32G431 应用层按 3.3V 逻辑设计，UART 输出为 3.3V 电平。
- HCT157 暂定使用 STM32 的 3.3V PWM 作为 B 输入，默认选择 PX4 原始 PWM。

## 本次新增确认信息

- Pixhawk 6C Mini 的 PWM 输出支持 3.3V 和 5V 两种硬件切换模式，需要检查实际板子焊接了哪个电压。
- Raptor 5 ESC 支持常规 1–2ms 标准 PWM 输入，上电时自动检测输入协议。
- Raptor 5 ESC 支持 3–6S 电池（厂家手册）；3S1P、4000mAh、标称 11.1V 电池在额定范围内（电池化学体系未确认，不作为匹配依据）。
- FLYSKY FS-SR8 使用 2.4GHz ANT 协议，输出可选 PWM、PPM、i-BUS 和 s-BUS（厂家资料：官方产品页与 FS-SR8 用户手册；2026-09-02 用户确认接收机一直为该型号，旧识读 FS-iA10B 已更正）。尚未确定 PX4 使用哪一种输出，不能由型号推断。
- PX4 当前固件经 NSH 确认为 1.17.0 精确提交；MAIN1/2 的 400 Hz、1000/1300 µs 通道行为已由成员 A 测量。旧的 v1.12.3 记录保留为历史，不再作为当前软件基线。
- L1 台面逻辑电源实测：WeAct 板 3.3V 输出 3.26V，USB-TTL 5V 输出 5.06V，两者与 HC14 共地。
- A3144E 无磁体时 OUT 被 4.7kΩ 上拉至 3.26V，HC14 1Y 为 0V；磁体靠近时 OUT 拉低、1Y 升为高电平。在本次 20 kHz 采样率、50 µs 时间分辨率及捕获窗口内，每个可见手动事件均有对应边沿，未观察到额外跳变或缺失边沿；该结果不能排除短于采样间隔的毛刺。
- 2026-09-02（Issue #5）：PulseView/sigrok 三通道同步采集（8 逻辑通道、20 kHz、50 µs 采样间隔；会话 342016 样本、约 17.10 s；D0=P0/A3144E OUT、D1=P2/HC14 1Y、D2=P1/HC14 1A）。本次供电实测 A3144E VCC 5.00V、HC14 VCC 3.25V；无磁体 P0/P1 3.24V、P2 0V。
- 原始输出 P0 与滤波后输入 P1 同相，整形输出 P2 与二者反相，符合 HC14 反相施密特逻辑。捕获窗口内可见 4 个完整低脉冲（P0/P1 同相各 4 个）与对应 4 个完整高脉冲（P2），P0/P1/P2 各 4 次上升沿与 4 次下降沿；全部边沿均构成上述完整脉冲、无窗口截断，可明确配对 4 次磁体靠近/离开循环。捕获窗口之外的手动操作总数未记录，不作推断。在本次 20 kHz 采样率、50 µs 时间分辨率及现有捕获窗口内，未观察到额外跳变、重复边沿或缺失的对应边沿；该证据不能排除短于采样间隔的毛刺，也不能替代最高预期频率验收。
- 手动高电平宽度取决于人手速度，不作为记录值；`1nF` 保留为起始滤波值。最高预期脉冲频率不丢脉冲尚未验收，依赖最终 RPM 范围与 PPR，不采用单片机方波模拟替代实机验收。
- Issue #5 三通道原始证据：`2026-09-02_hc14_raw_in_out_manual_1nF.{sr,pvs,png}`，纳入版本控制于 `data/raw/2026-09-02/`。
- 2026-09-03（Issue #6）：第二路使用独立第二颗 SN74HC14N 的 `1A/1Y`，RC 网络与第一路一致（4.7kΩ 上拉至 3.3V、1kΩ 串联、1nF 对地）。两路 HC14 均由 STM32 3.3V 供电，A3144E 由 CH340 5V 供电，全部共地。第一路 `1Y→PA0`、第二路 `1Y→PA1` 已实板接线并完成静态电平验证；STM32 TIM2 捕获待成员 B 烧录固件后实机验证。
- 2026-09-03 双路 L1 串扰检查：只触发第一路、只触发第二路、两路同时靠近/离开、两路反相动作四种条件下，另一路 HC14 `1Y` 均保持 0V，未观察到毛刺。线束抖动与拨线检查为手动观察，未保存波形文件。原始证据见 `data/raw/2026-09-03/`（sigrok 8 通道、20 kHz、50 µs 采样间隔）。
- 2026-09-04（Issue #6）：成员 B 经 ST-LINK 三线 SWD 下载并校验双路捕获固件，通过 PA9 单向 UART 记录无脉冲、Hall 1、Hall 2 与复位后双路捕获，两路 `chN_valid` 均置位、周期非零（`chN_valid` 为历史捕获标志，`chN_age_ms` 变化才表示新脉冲）。原始记录见 `data/raw/2026-09-04/`。项目负责人取消单独的手动周期对照；PPR 标定、最高预期脉冲频率和数字滤波结论转交 Issue #8。
- 触发距离暂测约 7mm（2 颗磁铁），随磁铁数量和安装位置变化，最终值待安装方案固定后复核。
- 原始采集与导出文件（sigrok `.sr`/`.pvs`、波形 PNG、距离 PNG）纳入版本控制于 `data/raw/2026-09-02/`（`.gitignore` 显式例外，PR #51），供成员直接复核；复核方式与元数据登记于 Issue #4。

## 本次测试边界

- 本节 L1 实测为真实硬件测量证据，非 synthetic/demo 数据；synthetic 数据不得作为本表确认依据。
- 仅验证单路 A3144E→HC14 在临时逻辑电源下的静态电平和手动磁触发，不证明双路 RPM、PPR 标定、最终安装距离、HCT157、闭环或电机运行。
- 2026-09-03 双路证据只覆盖逻辑信号链路与串扰；2026-09-04 UART 双路采集证明 TIM2 捕获路径已工作，但不证明 RPM 计算、PPR 标定、最终安装距离或电机运行。
- 原始波形与采集文件位于 `data/raw/2026-09-02/`（已纳入版本控制）；采样条件：sigrok 0.6.0，8 通道、20 kHz（采样间隔 50 µs）；Issue #4 会话 `2026-09-02_single_hall_manual_magnet.sr`，Issue #5 会话 `2026-09-02_hc14_raw_in_out_manual_1nF.sr`（342016 样本、约 17.10 s；D0=P0、D1=P2、D2=P1，其余通道未用于本次判定）。
- 2026-09-03 原始证据位于 `data/raw/2026-09-03/`：`2026-09-03_ch2_hc14_manual_1nF`（第二路单路）、`2026-09-03_crosstalk_ch1_only`、`2026-09-03_crosstalk_ch2_only`、`2026-09-03_crosstalk_both_same`、`2026-09-03_crosstalk_both_opposite`，每项含 `.sr/.pvs/.png`（opposite 的 PNG 文件名为 `025b370fd41ecfaac70a1901c8655fe5.png`）。线束抖动仅作观察记录，不纳入原始证据目录。
- Issue #5 三通道结论仅限于上述 20 kHz/50 µs 分辨率与捕获窗口：不能排除短于采样间隔（<50 µs）的毛刺，不替代“最高预期脉冲频率不丢脉冲”验收（该项依赖 RPM/PPR 标定与真实旋转条件）。

## 仍需补充确认的信息

- Pixhawk 6C Mini 实际 PWM 输出电平是 3.3V 还是 5V
- Raptor 5 ESC 对 3.3V 控制电平的实际接受度
- FS-SR8 最终使用 PWM、PPM、i.BUS 还是 s.BUS 输出
- 降压模块型号、输入电压范围、输出电压和额定电流
- SN74HCT157N 供电方案待定（SN74HC14N 3.3V 供电已实测）
- STM32 Hall 捕获已使用 `PA0/PA1 + TIM2_CH1/CH2`；PWM 输入已配置 `PB4/TIM3_CH1 + PB6/TIM4_CH1`，并已实机双路捕获验证；旁路和最终整机资源仍待验证
- A3144E 触发距离最终值（当前 2 颗磁铁约 7mm 为暂测）
- 最终逻辑供电方案（电池→降压模块→3.3V/5V）仍未验证

上述信息确认后，再逐项把 `TBD` 替换为实测值和证据。

## 参考来源

- Holybro Pixhawk 6C Mini PWM 信号电压说明：`https://docs.holybro.com/autopilot/pixhawk-6c-mini/pwm-signal-voltage-mod.md`
- Flycolor Raptor 5 说明书及第三方规格页
- FlySky FS-SR8 官方产品页：`https://www.flyskytech.com/parts_detail/113.html`
- FlySky FS-SR8 官方用户手册（PDF）：`https://flyskytech.com/u_file/photo/20250326/FS-SR8%20User%20manual%2020240619.pdf`
