enyyaalark/px4-dual-motor-rpm-sync/docs/project-plan.md

# 三周项目计划

周期：2026-08-31 至 2026-09-18，共 15 个工作日；周末不安排任务。建议负责人仅用角色表示。

按两名成员拆分的主责、逐日协作和交接条件见 [两人分工与三周协作安排](two-person-work-plan.md)。

## 第 1 周：双路 RPM 测量

| 日期 | role:hardware | role:firmware | 当日检查点 |
|---|---|---|---|
| 08-31 周一 | 确认型号/协议，建立电压接口表 | 配置开发环境，点灯/UART | 未知项进入 open questions |
| 09-01 周二 | 单路 A3144E/上拉/安装试验 | 输入捕获最小实验 | 手动触发可见 |
| 09-02 周三 | HC14 与 1nF 波形整形 | 周期/RPM 计算骨架 | 原始波形保存 |
| 09-03 周四 | 复制第二通道、检查串扰 | 双路捕获、超时归零 | 双路日志连续 |
| 09-04 周五 | 独立转速计标定 PPR | 校准参数和误差统计 | M1 评审：稳定显示双路 RPM |

## 第 2 周：完整控制链

| 日期 | role:hardware | role:firmware | 当日检查点 |
|---|---|---|---|
| 09-07 周一 | 确认 PX4 输出为标准 PWM | PX4 PWM 输入捕获 | 脉宽与分析仪一致 |
| 09-08 周二 | 检查 ESC 3.3V 接受度 | 双路 PWM 输出和限幅 | 仅接分析仪/无桨 |
| 09-09 周三 | 搭建 HCT157 默认旁路 | 旁路状态逻辑 | 复位默认 PX4 直通 |
| 09-10 周四 | 拆桨全链路接线复核 | UART CSV 完整记录 | 遥控两台无桨电机 |
| 09-11 周五 | 故障/复位快速复核 | 整理日志和问题 | M2 评审：全链路和 RPM 日志 |

## 第 3 周：同步控制与验证

| 日期 | role:hardware | role:firmware | 当日检查点 |
|---|---|---|---|
| 09-14 周一 | 重复条件开环基线 | 数据清洗和开环曲线 | 建立可比较基线 |
| 09-15 周二 | 监督拆桨调参 | 小增益 P、死区、限幅 | 无持续振荡 |
| 09-16 周三 | 霍尔断线/复位测试 | 抗饱和、故障状态 | 修正停止、旁路有效 |
| 09-17 周四 | 安全评审；条件满足才带桨 | 可选 PI/最终参数冻结 | 所有测试有 CSV |
| 09-18 周五 | 演示视频和硬件记录 | 对比曲线、最终报告 | M3 评审和未验证项清单 |

## 每日节奏

- 10 分钟：安全条件、前置任务和当天唯一目标。
- 实施：每次只改一个变量，保存原始证据。
- 15 分钟：交叉复核、更新 Issue、风险和下一步。

计划不是飞行承诺。若关键硬件、测量工具或安全条件未满足，任务应标记 `blocked` 并顺延，不压缩安全步骤。
