enyyaalark/px4-dual-motor-rpm-sync/data/raw/2026-09-02/2026-09-02_distance.png

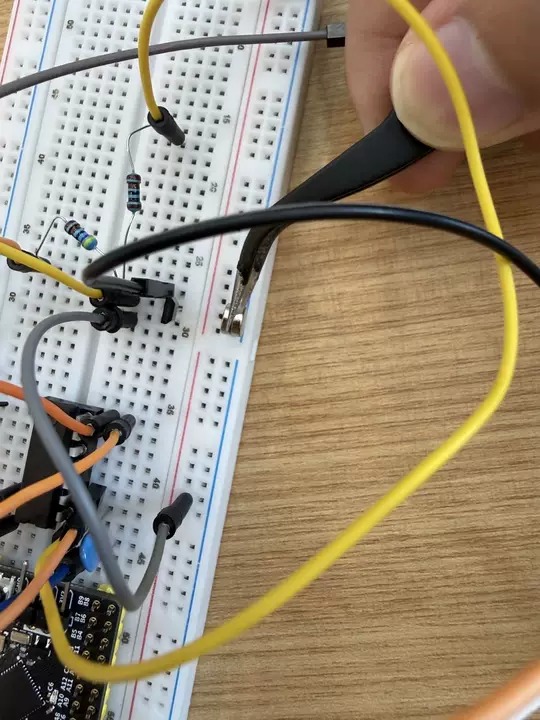
data/raw/2026-09-02/2026-09-02_distance.png
