enyyaalark/px4-dual-motor-rpm-sync/data/raw/2026-09-03/025b370fd41ecfaac70a1901c8655fe5.png

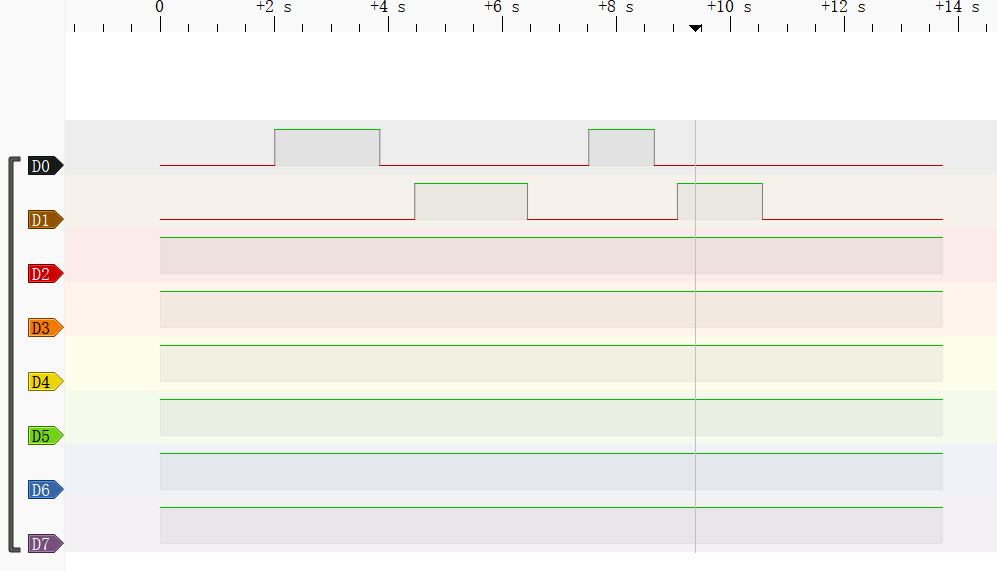
data/raw/2026-09-03/025b370fd41ecfaac70a1901c8655fe5.png
