enyyaalark/px4-dual-motor-rpm-sync/data/raw/2026-09-03/2026-09-03_crosstalk_ch2_only.png

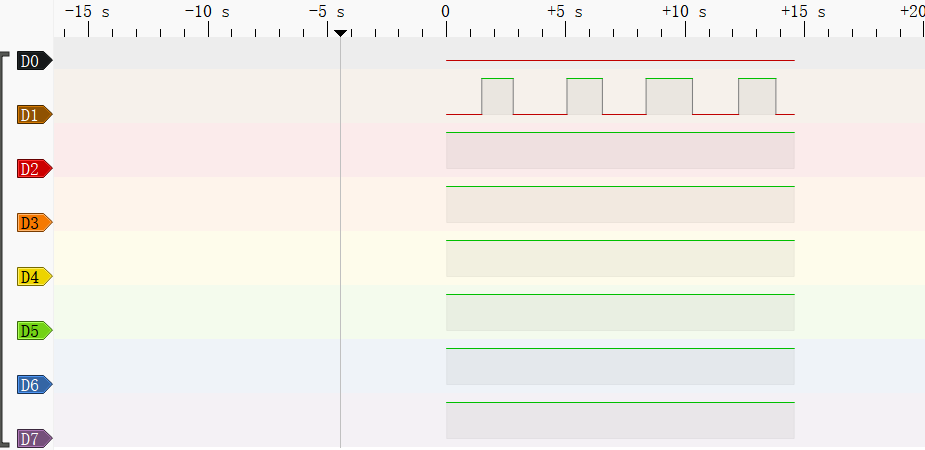
data/raw/2026-09-03/2026-09-03_crosstalk_ch2_only.png
