enyyaalark/px4-dual-motor-rpm-sync/docs/bill-of-materials.md

# 物料清单（BOM）

| 类别 | 物料 | 数量 | 状态 | 用途/备注 |
|---|---|---:|---|---|
| 飞控 | Pixhawk 6C Mini | 1 | 已有，照片确认；硬件修订/固件 `TBD` | 基础 PWM 与上层控制 |
| 遥控 | 遥控器与 FlySky FS-SR8 接收机 | 1 套 | 型号用户确认（旧照片识读 FS-iA10B 已更正）；遥控器型号及接收机实际输出模式 `TBD` | 厂家规格为 2.4GHz ANT 协议，输出可选 PWM/PPM/i-BUS/s-BUS |
| MCU | STM32G431CBU6 WeAct | 2 | 已有 | 主用+备用 |
| 动力 | RS2205 2300KV 电机 | 2 | 已有 | 台架对象 |
| 动力 | Flycolor Raptor5 G071-35A ESC | 2 | 用户确认两只同型号，固件标识均为 `Flycolor_Raptor_5` | 厂家规格 3–6S、35A 持续/40A 10 秒、无 BEC；固件版本号与配置待确认；第一阶段使用标准 PWM，电平待测 |
| 传感 | A3144E | 5 | 已有 | 2 使用、3 备用 |
| 逻辑 | SN74HC14N | 1+ | 已有 | 霍尔整形 |
| 逻辑 | SN74HCT157N | 1+ | 已有 | PWM 旁路选择 |
| 电阻 | 4.7kΩ | 2+ | 已有 | 霍尔上拉 |
| 电阻 | 1kΩ | 2+ | 已有 | 输入保护 |
| 电阻 | 10kΩ | 若干 | 已有 | 默认状态偏置 |
| 电容 | 1nF、10nF | 若干 | 已有 | 信号滤波实验 |
| 电容 | 100nF | 每 IC 1 个+ | 已有 | 去耦 |
| 电容 | 10–47µF | 若干 | 已有 | 逻辑电源入口滤波 |
| 调试 | ST-LINK V2、CH340 系列 USB-TTL | 各 1 | 已有；USB-TTL 精确后缀 `TBD` | USB-TTL 枚举为 `1a86:7523`；TXD 空闲高电平实测 5V，电平方案确认前禁止直连 STM32 |
| 测量 | 8通道24MHz逻辑分析仪、万用表 | 各 1 | 已有 | 数字波形和电气检查 |
| 结构 | 面包板、双面洞洞板 | 若干 | 已有 | 仅逻辑/信号，不承载主电流 |
| 线材 | UL2547 三芯 28AWG 屏蔽软线 | 按需 | 已有 | 霍尔低电流信号 |
| 供电 | 3S1P 电池、降压模块 | 1 套+ | 电池额定 3S1P/11.1V/4000mAh/100C（用户确认）；化学体系/满充电压/当前实测电压/连接器/线规及降压规格 `TBD` | 动力/逻辑供电；容量×C 换算的理论电流仍待标签/实测复核 |
| 机械 | 霍尔固定支架 | 2 | 可打印 | 尺寸和固定方式 `TBD` |
| 校准 | 独立激光转速计 | 1 | `TBD` | 必需；未确认是否已有 |
| 安全 | 刚性台架、防护罩、急停 | 1 套 | `TBD` | 带桨测试前必须具备 |

不在本项目中自动购买任何物料。缺失项应先建立 Issue 并由成员确认。
