enyyaalark/px4-dual-motor-rpm-sync/data/raw/2026-09-02/2026-09-02_hc14_raw_in_out_manual_1nF.png

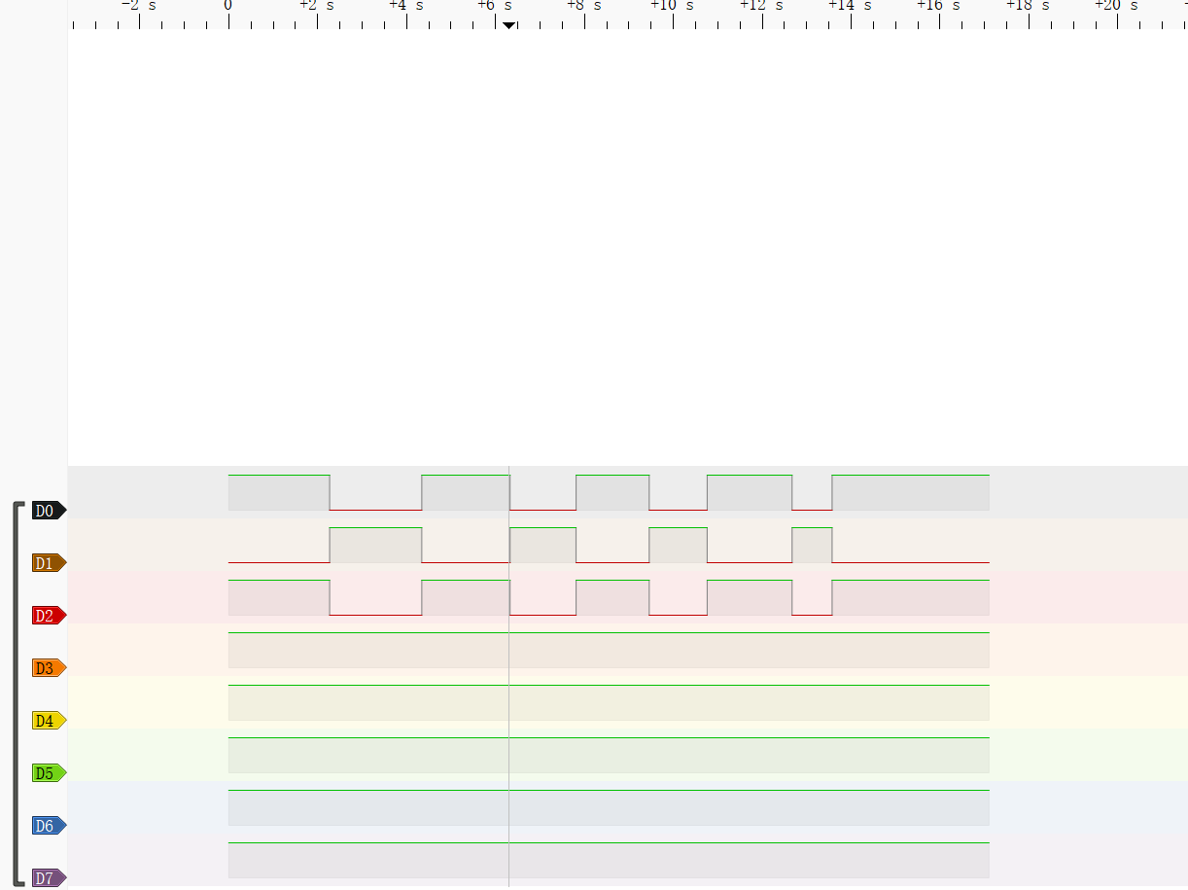
data/raw/2026-09-02/2026-09-02_hc14_raw_in_out_manual_1nF.png
