enyyaalark/px4-dual-motor-rpm-sync/data/raw/2026-09-02/2026-09-02_single_hall_manual_magnet.png

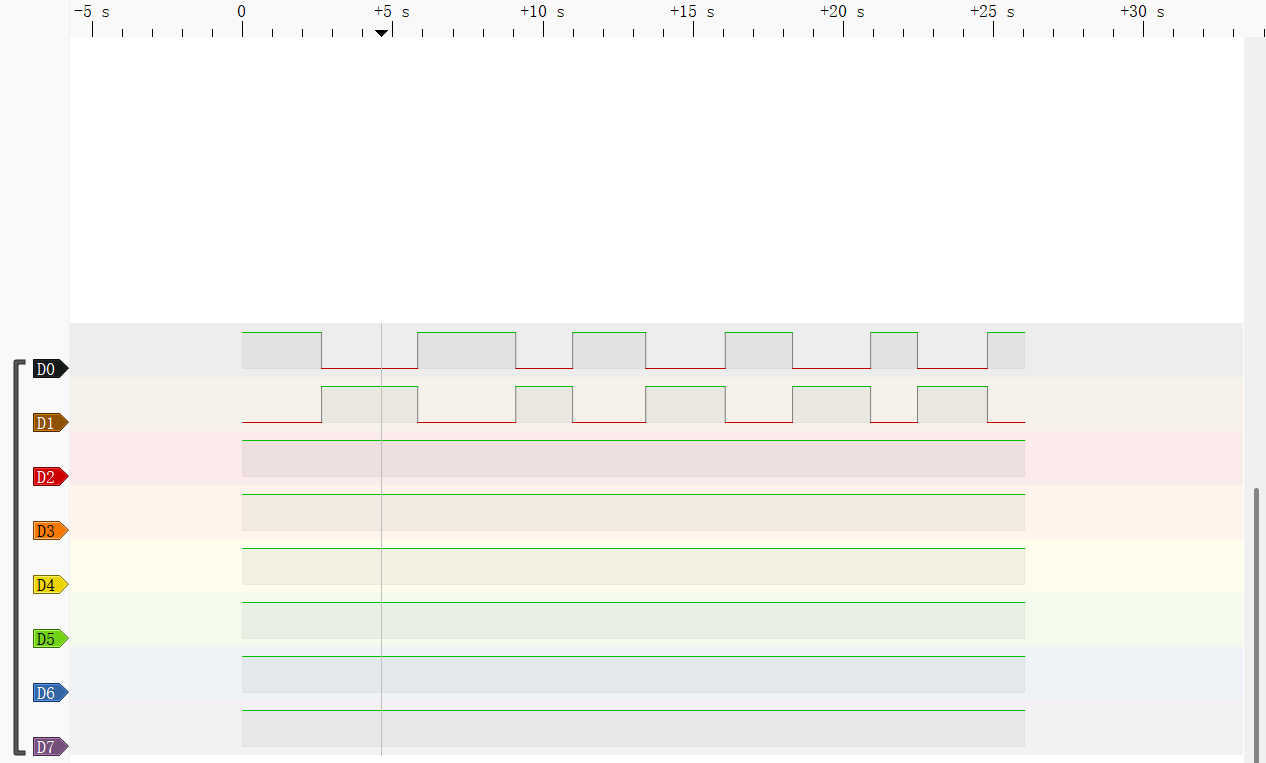
data/raw/2026-09-02/2026-09-02_single_hall_manual_magnet.png
