enyyaalark/px4-dual-motor-rpm-sync/CHANGELOG.md

# Changelog

本项目遵循“未验证不宣称”的原则。日期使用 `YYYY-MM-DD`。

## [Unreleased]

### Added

- 2026-09-16：同步控制器算法优化：`sync_controller` 的死区采用偏移补偿，并增加死区内状态清零、误差换向时滤波重置、有限值保护、稳定滤波系数和微分阻尼。台架初值为 `kp=0.01`、`kd=0.002`、`filter_tau_seconds=0.1`、`ki=0`；这些仍是台架参数，不代表飞行认证配置。主机语法检查、unittest 和 STM32 Release 交叉构建通过。

- 2026-09-15：Issue #13 v2 台架 PWM 范围同步：`app_config.hpp` 将修正输出边界从 `1100–1140µs` 更新为 `1060–1080µs`，新增 `kBasePwmMismatchUs=20U`；`system_controller` 改为同时评估 MAIN1/MAIN2 两路基础 PWM，两路均有效、脉宽差在 20µs 内且均不低于 1060µs 时才允许修正路径。适配层和 `main.c` 同步传入两路快照，新增 disarm 1000µs、双路不一致和单路超时主机测试。Debug/Release 交叉构建 0 errors/0 warnings，主机测试通过。实机 Hall/P 同步效果仍待磁体后台架验证。

- 2026-09-15：Issue #16 将闭环 `system_controller` 接入目标固件：新增 `system_controller_adapter` C++ 适配层，主循环每 20ms 执行一次控制步并输出 TIM1 修正 PWM、按状态切换 PB2 旁路；`app_config.hpp` 增加台架输出边界与待实测 P 初值（`kp=0.05`、`ki=0`、死区 10RPM、最低闭环 1000RPM、修正限幅 40µs）；新增 `rpm_sync_ctrl,v1` 遥测。Hall RPM 与 P 同步效果仍待安装磁体后实机验证。

- 2026-09-15：Issue #13 台架联调中发现 MAIN1 输入在 PA6 捕获接触不良，将 `PX4 PWM1` 捕获从 `PA6/TIM3_CH1` 改为 `PB4/TIM3_CH1`，保持 TIM3 PWM-input 模式不变；CubeMX 6.18.1 重新生成，Debug/Release 目标构建 0 errors/0 warnings，实机双路 PWM 输入均 `VALID`。Hall 双路仍待安装磁体后验证。

- 2026-09-15：Issue #11 在 `rpm_sync_capture.ioc` 加入 `PB2/BYPASS_SELECT` GPIO 输出（push-pull、no pull、low speed、初始低电平），并在 `MX_GPIO_Init()` 中先写输出锁存低电平再初始化；测试入口 `BYPASS_SELECT_TEST_ENABLE` 默认关闭。CubeMX 6.18.1 重新生成，Debug/Release 目标构建 0 errors/0 warnings，58/58 主机测试通过；HCT157 实机旁路验证仍待成员 A 完成。

- 2026-09-14：Issue #10 按成员 A 的配置同步在 `rpm_sync_capture.ioc` 加入 TIM1 双路 PWM 输出：`PA8/TIM1_CH1`、`PA10/TIM1_CH3`，1 MHz、Prescaler 15、Period 2499（400 Hz）、PWM mode 1、Active High、ARR/OC preload，初始 Pulse 0；`PA10` 脱离 USART1_RX，未接线的 `USART1_RX` 移到 `PB7`，`PA9` 保持遥测 TX。`main.c` 增加仅逻辑分析仪使用的测试入口（约 1000/1140 µs，同一 update event）。CubeMX 6.18.1 重新生成，Debug/Release 目标构建 0 errors/0 warnings，57/57 主机测试通过；尚未接逻辑分析仪实机验证，ESC/HCT157/电机/电池保持断开，闭环关闭。

- 2026-09-11：Issue #9 将 PX4 MAIN1/2 接入 PA6/TIM3_CH1 与 PB6/TIM4_CH1 独立 PWM-input/reset 捕获，增加有界 ISR 快照、C++17 范围/超时评估、版本化 UART 诊断和严格采集工具；CubeMX 临时副本重新生成、Debug/Release 目标构建及主机测试通过。950–1950 µs/10 ms 仅为 `MONITOR_ONLY` 初值，STM32 实机捕获和信号电平仍待验证，闭环保持关闭。
- 2026-09-11：Issue #9 首次实机 UART 检查测得双路约 2500 µs 周期和 999–1000 µs 高电平，同时暴露主循环时间早于中断快照的竞态；调整为先原子读取捕获快照、再获取评估时间，避免约 18 ms 的未来时间戳被无符号回绕误判为超时。

- 2026-09-11：Issue #7 纳入当前 main/v2 的双路稳定旋转与停转 UART 原始记录及证据回归测试；run1 的 35 个样本双路均为 `VALID`，run2 观察到双路 `VALID -> TIMED_OUT` 且 raw/effective RPM 归零。1 Hz 遥测不证明精确 100 ms 转换时刻，当次控制指令、电池电压和固定细节仍未记录。

- 2026-09-10：Issue #8 纳入两台拆桨电机各三个稳定点的 UART 周期原始记录、来源映射和离线 PPR 结果；六点均收敛到 `PPR=1`。KWS-ZS2508 精度和现场固件精确提交仍未确认，最高频率/数字滤波与 3% 精度验收继续保持未验证。

- 2026-09-04：Issue #10 增加双路 PWM 输出 C/C++ 薄适配层并链接目标工程，覆盖成对限幅、无效请求整组隔离和默认未标定配置禁用；ESC 刷新频率与范围仍为 `TBD`，因此未猜测或生成 TIM1 配置，也未启动物理输出。

- 2026-09-04：Issue #8 增加 PPR 标定计算工具和主机测试，按电机从多个参考 RPM/Hall 周期点生成整数 PPR 候选、逐点误差与保守精度判定；原始数据不可覆盖，缺少可追溯转速计精度时强制标记为未验证，不将 synthetic 计算或 1 RPM 分辨率表述为 3% 实机精度证据。

- 2026-09-04：Issue #7 将双路 TIM2 Hall 快照通过 C/C++ 薄适配层接入现有 RPM 评估逻辑，`rpm_sync_capture,v2` 增加原始/有效 RPM 和明确状态；UART 校验工具兼容历史 v1。PPR、超时和最大 RPM 仍为无效/TBD，当前目标构建只报告 `INVALID_CONFIG` 和零 RPM，闭环保持关闭。

- Issue #6 双路 Hall 捕获候选 CubeMX 配置：PA0/TIM2_CH1 与 PA1/TIM2_CH2 共用 1 MHz、32 位时间基准；加入有界 ISR 快照、双通道启动、主循环捕获遥测和配置回归测试。CubeMX 生成已验证，实机波形、滤波参数和 PPR 仍待验证。
- Issue #6 双路捕获 UART 校验工具：严格解析版本化遥测、统计双路有效样本，并以不可覆盖方式保存原始记录。
- 项目架构、硬件、接线、控制、UART、安全、校准、测试、计划、BOM、风险和开放问题文档。
- STM32G431 模块接口骨架与集中配置模板。
- synthetic/demo CSV、RPM 日志校验/绘图工具和基础测试。
- GitHub Issue/PR 模板、标签、里程碑与三周任务规划。
- AI 项目上下文、任务防重复规则和 Issue/Project 进度交接规范。
- 硬件无关 PWM 输入状态与 C++17 主机测试，覆盖零毫秒首样本、闭区间边界、越界隔离、超时、毫秒回绕和无效配置。
- 硬件无关 RPM 状态计算与 C++17 主机测试，覆盖首脉冲、32 位回绕、超时归零、无效配置和异常脉冲隔离。
- 硬件无关双路 PWM 输出校验与 C++17 主机测试，覆盖闭区间取整、独立限幅、无效配置和非有限请求的整组隔离。
- 硬件无关旁路/故障联合主机测试，覆盖复位默认直通、自检/人工门控、活动与锁存故障，以及故障时修正和积分归零。
- 硬件无关 UART CSV 格式化状态与 C++17/Python 交叉测试，覆盖固定 11 字段、全部状态名、非有限样本和缓冲区截断隔离。
- 硬件无关 `system_controller` 状态机组合层与 C++17 主机测试，覆盖 INIT/MONITOR_ONLY/SYNC_CONTROL/BYPASS/FAULT 迁移、旁路门控、故障刷新、低速禁止和基础 PWM 透传/修正输出；基础输入或双路输出无效时保持 PX4 原始旁路。
- `system_controller` 输入故障主机测试，覆盖 PWM 超时/越界和霍尔异常脉冲的故障位、原始旁路、修正与积分清零，以及当前非锁存恢复行为。
- 面向两名成员的角色分工、逐日协作、交接依赖和共同复核安排。
- 新增固件负责人待做清单，分开记录已完成、等待 PR 合并、可独立推进和硬件阻塞项。
- STM32Cube 工具链发现脚本、主机测试和点灯/UART 启动前检查说明。
- 基于 WeAct Studio QFN48 V1.0 官方原理图的 Issue #3 最小 CubeMX 点灯/UART 配置。
- 可交叉编译的 STM32CubeIDE 最小工程、PC6 点灯节拍和 PA9 单向 UART 版本心跳；固件基于 STM32CubeG4 v1.6.3 的必要 HAL/CMSIS 子集。
- Issue #3 配置回归测试，锁定板型、LED/SWD/UART 映射、MONITOR_ONLY 范围及工程元数据可移植性。
- Issue #3 Ubuntu 端 UART 心跳验收工具，支持有界读取、严格版本/板型/模式校验和不可覆盖的原始记录。
- `Debug`/`Release` 两个 configuration 的 `.bin` 产出（USB DFU 下载所需）及对应回归测试。
- Q12 排针可用性阻塞项，区分已组装的两侧 I/O 排针与仍未焊接的中央 SWD 孔位。
- 2026-09-02：Issue #5 HC14/1nF 手动验证——PulseView/sigrok 三通道同步采集 A3144E OUT、HC14 1A、1Y（8 通道、20 kHz、50 µs 采样间隔），确认静态电平与反相逻辑。会话 342016 样本（约 17.10 s）内可见 4 个完整低脉冲（D0/D2）与对应 4 个完整高脉冲（D1），D0/D1/D2 各 4 次上升沿与 4 次下降沿，可明确配对 4 次磁体靠近/离开循环；在此 20 kHz/50 µs 分辨率与捕获窗口内未观察到额外跳变、重复边沿或缺失的对应边沿，该证据不能排除短于采样间隔的毛刺，也不能替代最高预期频率验收。手动脉宽不作为记录值；`1nF` 保留为起始滤波值；最高预期脉冲频率不丢脉冲仍待测。原始证据纳入 `data/raw/2026-09-02/`。
- 2026-09-02：L1 单路 A3144E 霍尔链路实测（对应 Issue #4 验收项：静态电平、手动触发波形、2 颗磁铁约 7mm 暂测距离）。原始证据（sigrok `.sr`/`.pvs`、波形与距离 PNG）纳入版本控制于 `data/raw/2026-09-02/`（`.gitignore` 显式例外，PR #51），并在 Issue #4 登记元数据与复核方式。Issue #1/#2 仍开放，未标记完成。
- 2026-09-03：Issue #6 双路 A3144E→HC14 L1 串扰验证——第二路使用独立第二颗 SN74HC14N `1A/1Y`，与第一路同型 RC 网络、3.3V 供电和共地；两路 `1Y` 分别接到候选 `PA0/PA1`。只触发单路、两路同时和反相动作均互不影响，未观察到毛刺；线束抖动为无波形观察记录。原始证据（sigrok 8 通道、20 kHz、50 µs 采样间隔）纳入 `data/raw/2026-09-03/`。STM32 TIM2 捕获、RPM 与最高预期脉冲频率仍待验证。

### Changed

- 2026-09-16：Issue #15/#16 本地台架 A/B 初步验证中，MAVLink 固定执行器输入的同步段获得 45/45 个有效控制样本、Hall/PWM 双路有效率 100%、全程 `state=2` 且 `fault=0x0`。与 baseline 在共同 `base_us=1062` 区间比较，中位绝对误差由 200 RPM 降至 94 RPM，P95 由 274 RPM 降至 131 RPM；同步全段中位误差为 87 RPM/4%，判定 `IMPROVED`。原始数据按策略仅保留本地，GitHub 只登记文件名、SHA-256 和统计；baseline 仍含 UART 损坏字节，需用同一 MAVLink 输出补采后再关闭验收项。

- 2026-09-16：保留工作树中已存在的 `system_controller_adapter.cpp` Hall 源交换：台架将 Hall1（TIM2_CH1）接在 TIM1_CH3 驱动的电机、Hall2（TIM2_CH2）接在 TIM1_CH1 驱动的电机，适配层交换后使 `rpm1/rpm2` 与 TIM1 输出通道一致。该映射依赖台架接线，仍需成员 A 复核确认。

- 2026-09-16：`kKpDefault` 从 0.05 调整为 0.01，降低比例增益以减少台架同步的过冲/振荡；仍为待标定初值，闭环默认关闭。

- 2026-09-05：Issue #14 的 `rpm_sync_capture,v2` 校验器增加 RPM 状态/数值语义检查，拒绝非 `VALID` 状态携带有效 RPM、等待状态携带周期或有效状态缺少一致原始值；完整 11 字段目标发送继续等待有效 PWM/状态机数据源，不用全零占位伪装完成。

- 2026-09-10：按 Issue #8 团队风险接受设置 `kHallTimeoutMs=100U` 和 `kMaximumRpm=3300.0F` 作为 `MONITOR_ONLY` 待验证初值；3000 RPM 台架安全上限不变，闭环仍关闭，停止归零、最高频率和数字滤波仍未独立验收。

- 2026-09-10：集中配置将经多点实测复核的 `kPulsesPerRevolution` 从无效值更新为 `1.0F`；该 PPR 数据变更本身不启用闭环，Hall 超时和最大 RPM 的后续工程初值见上条记录。

- 2026-09-04：同步 README 与固件负责人交接入口至 PR #66/#67/#68 合并后的实际状态，明确 #7/#8/#10 仅完成软件切片、父 Issue 仍受实机参数和安全前置阻塞，并将 #14 目标数据源/UART 语义校验列为下一项可独立推进工作。

- 2026-09-04：同步仓库阶段摘要与 Issue #6 已合并基线：双路 Hall 引脚、CubeMX、HAL 捕获、UART 遥测/校验工具和成员 A 接线交接已完成；实机捕获波形、PPR/RPM、PWM 与旁路继续标为未验证。
- 2026-09-04：按成员 A 的 Issue #6 实际接线更正双路 HC14 门编号：第一路使用第一颗 SN74HC14N `1A/1Y -> PA0`，第二路使用第二颗 SN74HC14N `1A/1Y -> PA1`；同步更新 Hall 捕获的 CubeMX/接线状态，双路实机波形仍待验证。
- 2026-09-04：Issue #48 完成 STM32 三线 SWD 调试链路验证：成员 A 复核接线与隔离条件，成员 B 连续两次只读识别目标，断开后原 PC6 点灯固件恢复正常；未擦除、下载或修改选项字节，Q12 相应关闭。
- 2026-09-04：Issue #6 双路 Hall 捕获 L1 实机完成——PR #65（双路 L1 串扰证据）合并（`e7b0802`）；捕获固件经 ST-LINK 三线 SWD 下载并校验；PA0/PA1 经 UART 记录无脉冲、Hall 1、Hall 2 与复位后双路捕获，两路 `chN_valid` 均置位、周期非零。`chN_valid` 是历史捕获标志，`chN_age_ms` 变化才表示新脉冲；手动脉冲周期不作为 RPM/PPR 证据。项目负责人取消单独的手动周期对照并按修订范围关闭 #6；PPR、最高频率和数字滤波结论转交 #8。
- 2026-09-03：用户确认核心板中央 `DIO/CLK/GND` SWD 排针已焊接；Q12、接线说明和焊接清单同步更新。三线连接、目标识别和断开后的原固件恢复仍未验证，由 Issue #48 继续跟踪。
- 2026-09-03：Issue #6 增加 STM32G431 双路 Hall、双路 PX4 PWM 输入、双路 ESC PWM 输出和旁路选择的无冲突候选引脚/定时器方案，并记录中断最小化、共享 32 位 Hall 时间基准和同步 PWM 更新设计；最终落针、时钟、波形和 `.ioc` 继续等待实物与 CubeMX 复核。
- STM32 应用层技术栈确定为 C++17，模块扩展名改为 `.cpp/.hpp`。
- 增加 C++17 主机语法检查，并明确 CubeMX HAL C 与应用层的 ABI 适配边界。
- `docs/voltage-interface-table.md`：补充 A3144E→HC14 单路 L1 实测电平、触发行为与临时逻辑电源记录。
- `docs/voltage-interface-table.md`：记录 Issue #5 三通道 HC14 整形复核条件与证据文件；明确 `1nF` 起始值保留、高频验收待测。
- 更正接收机型号识别：FlySky FS-iA10B → FS-SR8（2026-09-01 依照片识读有误；用户 2026-09-02 确认接收机一直为 FS-SR8）。FS-SR8 的 2.4GHz ANT 协议与 PWM/PPM/i-BUS/s-BUS 输出能力按 FlySky 官方产品页/手册记录；实际输出模式保持 `TBD`，不能由型号推断。同步更新 README、hardware-overview、bill-of-materials、open-questions 与电压接口表。
- 电池额定信息更新为 3S1P、11.1V、4000mAh、100C（用户 2026-09-02 确认容量）；表格不再把化学体系写成已确认的 LiPo，化学体系、满充/当前实测电压、连接器和线规保持 `TBD`。
- 两只 Raptor5 G071-35A ESC 的固件标识确认为 `Flycolor_Raptor_5`（用户确认）；固件版本号、配置参数、3.3V 控制电平接受度与失联行为保持 `TBD`。
- PWM 捕获层只保存原始样本；范围与超时改由周期任务通过显式配置判断，未标定默认范围保持零值/无效。
- PWM 输出边界改由调用方显式提供；未标定默认范围保持零值/无效，HAL 接入前必须检查整组输出状态。
- UART CSV 格式化改为显式状态和成功长度；无效样本或不足缓冲区不得留下可发送的部分行。
- RPM 采集状态不再用零时间戳表示“尚无脉冲”；诊断原始 RPM 与可供后续控制使用的有效 RPM 分离。
- 记录 CH340 系列 USB-TTL 的枚举信息和 5V TXD 实测阻塞，要求确认 3.3V 配置或电平转换后再连接 STM32。
- 明确 Issue #3 首次下载采用核心板 USB-C 单路供电，ST-LINK 只接 SWCLK、SWDIO 和 GND。
- 实板确认核心板 USB-C 的 STM32 ROM DFU 下载路径可用；Issue #3 固件写入校验、PC6 LED 复位启动和断电冷启动观察通过，ST-LINK 改为调试/回退路径。
- 记录 Linux 下 `0483:df11` 需要 udev 规则，以及 `-g` 跳转启动因 bootloader 残留 HSI48/PLL 可能停在 `Error_Handler()`，点灯判定必须冷启动或按 `RESET`。
- 标注 SWD 三线位于 100mil 排针孔位，需先焊接排针，并说明无焊台时改用 USB DFU。
- 记录 Ubuntu `brltty-udev` 抢占 CH340、导致 `ttyUSB0` 立即消失的诊断特征及仅本次启动生效的恢复步骤。
- 实板确认 `PA9/USART1_TX -> CH340 RXD` 的 115200 8N1 单向心跳；首次采集获得 3 条完整心跳，USB-C 断电约 5 秒后再采集仍获得 3/3 条有效心跳。
- 实板 UART 连续 30 秒稳定性采集获得 10/10 条格式匹配心跳。
- 完善硬件无关的同步控制器边界：RPM 死区、对称修正限幅、积分限幅和饱和方向条件积分抗 windup，并增加实际 C++ 控制器执行测试。
- 澄清项目状态：STM32 最小 bring-up 与硬件无关控制保护已超前完成，但 M1 所需的霍尔/PPR/RPM 实机条件仍未满足。
- 根据实物照片与厂家资料部分确认 Pixhawk 6C Mini、FlySky FS-iA10B 和一只 Flycolor Raptor5 G071-35A；硬件修订、实际协议/固件、电平与第二只电调一致性继续保持 `TBD`。
- 通过 USB/MAVLink 只读确认 Pixhawk 运行 PX4 v1.12.3，并记录当前 HIL Quadcopter X 机架与 MAIN PWM 参数；因机架配置不符合双发固定翼目标，在独立评审和波形验证前阻止动力连接。
- 记录验证结构为双发后推布局、两只 Flycolor Raptor5 G071-35A 电调一致，以及电池为 3S1P/额定 11.1V/100C；容量、实测电压和动力连接条件继续保持 `TBD`。
- 固定第一阶段台架逻辑映射为 Pixhawk MAIN1 对应左侧后推电机、MAIN2 对应右侧后推电机，两路使用相同基础指令；电气验证和错误机架配置的安全阻塞保持不变。
- 更正 Pixhawk 照片方位记录：现有照片为外壳底面；底面可确认端口编号，但未显示可读的硬件修订或 PWM 电压选择信息。

### Not verified

- 其他电气接口、PWM、RPM、旁路和闭环控制行为尚未实机验证。
- RPM 主机测试仅使用 synthetic 参数；最终 PPR、计时器频率、超时、最大 RPM、异常跳变阈值和实机误差仍未验证。
- PWM 主机测试仅使用 synthetic 参数；PX4 输出协议、频率、电平、实际脉宽范围、捕获精度和双路实机行为仍未验证。
