enyyaalark/px4-dual-motor-rpm-sync/docs/risk-register.md

# 风险登记

等级：可能性/影响使用低、中、高。状态均为“未验证”。

| ID | 风险 | 可能性 | 影响 | 预防措施 | 触发条件 | 应急方案 |
|---|---|---|---|---|---|---|
| R01 | 霍尔无法隔着电机外壳稳定检测磁场 | 高 | 高 | 可调支架；先手动/低能量扫描；准备外置磁体方案评审 | 脉冲缺失或位置极敏感 | 停止闭环，重新设计检测方式 |
| R02 | 霍尔脉冲受 ESC/三相线干扰 | 中 | 高 | 屏蔽线、远离动力线、HC14、RC 从 1nF 起、波形记录 | 油门升高出现毛刺/计数跳变 | 旁路，调整走线/滤波后重测 |
| R03 | 每转脉冲数判断错误 | 中 | 高 | 独立转速计多点标定 | 计算 RPM 与参考成固定倍数偏差 | 禁止闭环，修正 PPR 并重跑全部校准 |
| R04 | PX4 输出不是标准 PWM | 中 | 高 | 确认板型/固件/参数并用分析仪测量 | 无稳定 1000–2000µs 类脉冲 | 标记 blocked，重新选择接口方案 |
| R05 | ESC 不接受 3.3V 控制电平 | 中 | 高 | 查数据手册并拆桨实测；预留电平转换评审 | 输出波形正确但 ESC 不响应/间歇响应 | 停止测试，增加合规电平转换 |
| R06 | HCT157 旁路默认状态错误 | 中 | 严重 | 复位默认偏置、上电/掉电/复位波形测试 | MCU 未就绪时输出不是 PX4 | 断开动力，修正硬件后禁止继续 |
| R07 | PI 参数导致振荡 | 中 | 严重 | 先 P 后 PI、小增益、限幅、抗饱和 | RPM/PWM 持续往复或幅度扩大 | 立即旁路/降油门，Ki 归零复盘 |
| R08 | 单侧电机故障时控制器错误增大输出 | 中 | 严重 | 故障检测、最大修正、低 RPM 禁止闭环 | 一侧 RPM 降低且修正持续饱和 | 停止积分与修正，进入旁路/安全状态 |
| R09 | 杜邦线/面包板接触不良 | 高 | 高 | 仅用于低能量验证；关键连接焊接/锁定；拉力检查 | 触碰/振动导致信号跳变 | 断电，改用可靠连接并重测 |
| R10 | 带桨测试造成机械伤害 | 中 | 严重 | 刚性台架、防护罩、急停、远程操作、人员离开桨盘 | 固定松动、异常振动、人员进入警戒区 | 立即急停并撤离，完全停转后检查 |
| R11 | PX4 主动要求差动推力 | 中 | 严重 | 第一阶段只在基础指令相同条件下闭环；检测目标差异 | 两路 PX4 目标不一致 | 退出同步，保留 PX4 原始差异 |
| R12 | 当前旁路无法覆盖 MCU 全部锁死 | 高 | 严重 | 明确限制、看门狗评估、输出合理性监控 | MCU 输出粘连但选择信号未切换 | 外部急停；后续增加独立硬件看门狗 |

风险每次里程碑评审更新。任何“严重”风险的预防条件未满足时，相关测试不得开始。
