enyyaalark/px4-dual-motor-rpm-sync/firmware/stm32/Src/main.c

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
/* Includes ------------------------------------------------------------------*/
#include "main.h"
#include "tim.h"
#include "usart.h"
#include "gpio.h"

/* USER CODE BEGIN Includes */

#include "hall_capture.h"
#include "pwm_input_capture.h"
#include "pwm_input_evaluator.h"
#include "rpm_evaluator.h"
#include "system_controller_adapter.h"
#include <stdio.h>

/* USER CODE END Includes */

/* USER CODE BEGIN PD */

#define STATUS_LED_PERIOD_MS 500U
#define TELEMETRY_PERIOD_MS 1000U
#define TELEMETRY_TIMEOUT_MS 20U
#define BYPASS_SELECT_TEST_ENABLE 0U
#define BYPASS_SELECT_TEST_PERIOD_MS 2000U
#define CONTROL_PERIOD_MS 20U
#define SYNC_CONTROL_ENABLE 1U

/* USER CODE END PD */


/* USER CODE BEGIN PV */

static uint32_t last_led_tick_ms;
static uint32_t last_telemetry_tick_ms;
static uint32_t last_bypass_tick_ms;
static uint32_t last_control_tick_ms;
static HallCaptureSnapshot hall_snapshots[2];
static RpmEvaluationResult rpm_results[2];
static PwmInputCaptureSnapshot pwm_input_snapshots[2];
static PwmInputEvaluationResult pwm_input_results[2];
static SystemControllerAdapterResult controller_result;
static uint8_t capture_telemetry[320];
static uint8_t pwm_input_telemetry[320];
static uint8_t ctrl_telemetry[256];
static const uint8_t telemetry_heartbeat[] =
  "rpm_sync_bringup,v1,board=weact_g431_qfn48,mode=MONITOR_ONLY\r\n";

/* USER CODE END PV */

void SystemClock_Config(void);
/**
  * @brief  The application entry point.
  * @retval int
  */
int main(void)
{

  /* MCU Configuration--------------------------------------------------------*/

  /* Reset of all peripherals, Initializes the Flash interface and the Systick. */
  HAL_Init();

  /* Configure the system clock */
  SystemClock_Config();

  /* Initialize all configured peripherals */
  MX_GPIO_Init();
  MX_TIM2_Init();
  MX_TIM3_Init();
  MX_TIM4_Init();
  MX_USART1_UART_Init();
  MX_TIM1_Init();
  /* USER CODE BEGIN 2 */

  last_led_tick_ms = HAL_GetTick();
  last_telemetry_tick_ms = last_led_tick_ms;
  last_bypass_tick_ms = last_led_tick_ms;
  (void)HAL_UART_Transmit(&huart1,
                         (uint8_t *)telemetry_heartbeat,
                         sizeof(telemetry_heartbeat) - 1U,
                         TELEMETRY_TIMEOUT_MS);

  if (HallCapture_Start(&htim2) != HAL_OK)
  {
    Error_Handler();
  }

  if (PwmInputCapture_Start(&htim3, &htim4) != HAL_OK)
  {
    Error_Handler();
  }

  __HAL_TIM_ENABLE_OCxPRELOAD(&htim1, TIM_CHANNEL_1);
  __HAL_TIM_ENABLE_OCxPRELOAD(&htim1, TIM_CHANNEL_3);
  __HAL_TIM_SET_COMPARE(&htim1, TIM_CHANNEL_1, 0U);
  __HAL_TIM_SET_COMPARE(&htim1, TIM_CHANNEL_3, 0U);
  if (HAL_TIM_PWM_Start(&htim1, TIM_CHANNEL_1) != HAL_OK)
  {
    Error_Handler();
  }
  if (HAL_TIM_PWM_Start(&htim1, TIM_CHANNEL_3) != HAL_OK)
  {
    Error_Handler();
  }

  SystemControllerAdapter_Init();
  SystemControllerAdapter_SetSyncEnabled(SYNC_CONTROL_ENABLE);
  last_control_tick_ms = last_led_tick_ms;

  /* USER CODE END 2 */

  /* Infinite loop */
  /* USER CODE BEGIN WHILE */
  while (1)
  {
    /* USER CODE END WHILE */

    /* USER CODE BEGIN 3 */
    const uint32_t now_ms = HAL_GetTick();

    if ((now_ms - last_led_tick_ms) >= STATUS_LED_PERIOD_MS)
    {
      last_led_tick_ms = now_ms;
      HAL_GPIO_TogglePin(STATUS_LED_GPIO_Port, STATUS_LED_Pin);
    }

    if ((now_ms - last_control_tick_ms) >= CONTROL_PERIOD_MS)
    {
      const uint32_t previous_control_tick = last_control_tick_ms;
      last_control_tick_ms = now_ms;
      const float dt_seconds =
          (float)(now_ms - previous_control_tick) / 1000.0F;

      HallCapture_Read(hall_snapshots);
      PwmInputCapture_Read(pwm_input_snapshots);
      controller_result = SystemControllerAdapter_Step(
          hall_snapshots, pwm_input_snapshots, now_ms, dt_seconds);

      __HAL_TIM_SET_COMPARE(&htim1, TIM_CHANNEL_1, controller_result.pwm1_us);
      __HAL_TIM_SET_COMPARE(&htim1, TIM_CHANNEL_3, controller_result.pwm2_us);

      const uint8_t sync_active = (controller_result.state == 2U);
      HAL_GPIO_WritePin(BYPASS_SELECT_GPIO_Port, BYPASS_SELECT_Pin,
                        (sync_active && controller_result.select_corrected) ?
                        GPIO_PIN_SET : GPIO_PIN_RESET);
    }

#if BYPASS_SELECT_TEST_ENABLE
    /* Logic-analyzer-only bypass-select exercise. Disabled by default so
       PB2 stays low and the external HCT157 keeps selecting PX4 A inputs. */
    if ((now_ms - last_bypass_tick_ms) >= BYPASS_SELECT_TEST_PERIOD_MS)
    {
      last_bypass_tick_ms = now_ms;
      HAL_GPIO_TogglePin(BYPASS_SELECT_GPIO_Port, BYPASS_SELECT_Pin);
    }
#endif

    if ((now_ms - last_telemetry_tick_ms) >= TELEMETRY_PERIOD_MS)
    {
      last_telemetry_tick_ms = now_ms;
      HallCapture_Read(hall_snapshots);
      const uint32_t hall_now_ms = HAL_GetTick();
      for (uint32_t channel = 0U; channel < 2U; ++channel)
      {
        const RpmEvaluationInput input = {
          hall_snapshots[channel].period_ticks,
          hall_snapshots[channel].last_pulse_ms,
          hall_snapshots[channel].has_pulse,
          hall_snapshots[channel].has_period
        };
        rpm_results[channel] =
          RpmEvaluator_EvaluateConfigured(&input, hall_now_ms);
      }
      const int telemetry_length = snprintf(
        (char *)capture_telemetry,
        sizeof(capture_telemetry),
        "rpm_sync_capture,v2,t_ms=%lu,ch1_valid=%u,ch1_period_us=%lu,"
        "ch1_age_ms=%lu,ch1_raw_rpm=%lu,ch1_rpm=%lu,ch1_status=%s,"
        "ch2_valid=%u,ch2_period_us=%lu,ch2_age_ms=%lu,ch2_raw_rpm=%lu,"
        "ch2_rpm=%lu,ch2_status=%s\r\n",
        (unsigned long)hall_now_ms,
        (unsigned int)hall_snapshots[0].has_period,
        (unsigned long)rpm_results[0].period_ticks,
        (unsigned long)(hall_now_ms - hall_snapshots[0].last_pulse_ms),
        (unsigned long)rpm_results[0].raw_rpm,
        (unsigned long)rpm_results[0].rpm,
        RpmEvaluator_StatusName(rpm_results[0].status),
        (unsigned int)hall_snapshots[1].has_period,
        (unsigned long)rpm_results[1].period_ticks,
        (unsigned long)(hall_now_ms - hall_snapshots[1].last_pulse_ms),
        (unsigned long)rpm_results[1].raw_rpm,
        (unsigned long)rpm_results[1].rpm,
        RpmEvaluator_StatusName(rpm_results[1].status));

      if ((telemetry_length > 0) &&
          ((size_t)telemetry_length < sizeof(capture_telemetry)))
      {
        (void)HAL_UART_Transmit(&huart1,
                               capture_telemetry,
                               (uint16_t)telemetry_length,
                               TELEMETRY_TIMEOUT_MS);
      }

      PwmInputCapture_Read(pwm_input_snapshots);
      const uint32_t pwm_input_now_ms = HAL_GetTick();
      for (uint32_t channel = 0U; channel < 2U; ++channel)
      {
        const PwmInputEvaluationInput input = {
          pwm_input_snapshots[channel].pulse_width_us,
          pwm_input_snapshots[channel].last_update_ms,
          pwm_input_snapshots[channel].has_sample
        };
        pwm_input_results[channel] =
          PwmInputEvaluator_EvaluateConfigured(&input, pwm_input_now_ms);
      }
      const int pwm_input_telemetry_length = snprintf(
        (char *)pwm_input_telemetry,
        sizeof(pwm_input_telemetry),
        "rpm_sync_pwm_input,v1,t_ms=%lu,"
        "ch1_seen=%u,ch1_period_us=%lu,ch1_raw_us=%u,ch1_us=%u,"
        "ch1_age_ms=%lu,ch1_status=%s,"
        "ch2_seen=%u,ch2_period_us=%lu,ch2_raw_us=%u,ch2_us=%u,"
        "ch2_age_ms=%lu,ch2_status=%s\r\n",
        (unsigned long)pwm_input_now_ms,
        (unsigned int)pwm_input_snapshots[0].has_sample,
        (unsigned long)pwm_input_snapshots[0].period_us,
        (unsigned int)pwm_input_results[0].raw_pulse_width_us,
        (unsigned int)pwm_input_results[0].pulse_width_us,
        (unsigned long)(pwm_input_now_ms -
                        pwm_input_snapshots[0].last_update_ms),
        PwmInputEvaluator_StatusName(pwm_input_results[0].status),
        (unsigned int)pwm_input_snapshots[1].has_sample,
        (unsigned long)pwm_input_snapshots[1].period_us,
        (unsigned int)pwm_input_results[1].raw_pulse_width_us,
        (unsigned int)pwm_input_results[1].pulse_width_us,
        (unsigned long)(pwm_input_now_ms -
                        pwm_input_snapshots[1].last_update_ms),
        PwmInputEvaluator_StatusName(pwm_input_results[1].status));

      if ((pwm_input_telemetry_length > 0) &&
          ((size_t)pwm_input_telemetry_length < sizeof(pwm_input_telemetry)))
      {
        (void)HAL_UART_Transmit(&huart1,
                               pwm_input_telemetry,
                               (uint16_t)pwm_input_telemetry_length,
                               TELEMETRY_TIMEOUT_MS);
      }

      const int ctrl_telemetry_length = snprintf(
        (char *)ctrl_telemetry,
        sizeof(ctrl_telemetry),
        "rpm_sync_ctrl,v1,t_ms=%lu,base_us=%u,pwm1_us=%u,pwm2_us=%u,"
        "rpm1=%lu,rpm2=%lu,error_rpm=%ld,error_percent=%ld,"
        "correction_us=%ld,select=%u,state=%u,fault=0x%lx\r\n",
        (unsigned long)now_ms,
        (unsigned int)controller_result.base_pwm_us,
        (unsigned int)controller_result.pwm1_us,
        (unsigned int)controller_result.pwm2_us,
        (unsigned long)controller_result.rpm1,
        (unsigned long)controller_result.rpm2,
        (long)controller_result.error_rpm,
        (long)controller_result.error_percent,
        (long)controller_result.correction_us,
        (unsigned int)controller_result.select_corrected,
        (unsigned int)controller_result.state,
        (unsigned long)controller_result.fault_flags);

      if ((ctrl_telemetry_length > 0) &&
          ((size_t)ctrl_telemetry_length < sizeof(ctrl_telemetry)))
      {
        (void)HAL_UART_Transmit(&huart1,
                               ctrl_telemetry,
                               (uint16_t)ctrl_telemetry_length,
                               TELEMETRY_TIMEOUT_MS);
      }
    }
  }
  /* USER CODE END 3 */
}

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
/* USER CODE BEGIN 4 */

void HAL_TIM_IC_CaptureCallback(TIM_HandleTypeDef *htim)
{
  HallCapture_OnInterrupt(htim);
  PwmInputCapture_OnInterrupt(htim);
}

/* USER CODE END 4 */
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
