enyyaalark/px4-dual-motor-rpm-sync/firmware/stm32/rpm_sync_capture.ioc

Mcu.UserName=STM32G431CBUx
PA0.GPIO_Label=HALL1_CAPTURE
PA0.Signal=S_TIM2_CH1
PA1.GPIO_Label=HALL2_CAPTURE
PA1.Signal=S_TIM2_CH2
PB4.GPIO_Label=PX4_PWM1_CAPTURE
PB4.Signal=S_TIM3_CH1
PA8.GPIO_Label=ESC1_PWM_OUT
PA8.Signal=S_TIM1_CH1
PA10.GPIO_Label=ESC2_PWM_OUT
PA10.Signal=S_TIM1_CH3
PA13.Signal=SYS_JTMS-SWDIO
PA14.Signal=SYS_JTCK-SWCLK
PB6.GPIO_Label=PX4_PWM2_CAPTURE
PB6.Signal=S_TIM4_CH1
PA9.GPIO_Label=TELEMETRY_TX
PA9.Signal=USART1_TX
PB7.GPIO_Label=TELEMETRY_RX_UNUSED
PB7.Signal=USART1_RX
PC6.GPIO_Label=STATUS_LED
PC6.Signal=GPIO_Output
PB2.GPIO_Label=BYPASS_SELECT
PB2.Signal=GPIO_Output
