enyyaalark/px4-dual-motor-rpm-sync/firmware/stm32/Inc/main.h

#define HALL1_CAPTURE_Pin GPIO_PIN_0
#define HALL1_CAPTURE_GPIO_Port GPIOA
#define HALL2_CAPTURE_Pin GPIO_PIN_1
#define HALL2_CAPTURE_GPIO_Port GPIOA
#define PX4_PWM1_CAPTURE_Pin GPIO_PIN_4
#define PX4_PWM1_CAPTURE_GPIO_Port GPIOB
#define PX4_PWM2_CAPTURE_Pin GPIO_PIN_6
#define PX4_PWM2_CAPTURE_GPIO_Port GPIOB
#define BYPASS_SELECT_Pin GPIO_PIN_2
#define BYPASS_SELECT_GPIO_Port GPIOB
#define STATUS_LED_Pin GPIO_PIN_6
#define STATUS_LED_GPIO_Port GPIOC
#define ESC1_PWM_OUT_Pin GPIO_PIN_8
#define ESC1_PWM_OUT_GPIO_Port GPIOA
#define TELEMETRY_TX_Pin GPIO_PIN_9
#define TELEMETRY_TX_GPIO_Port GPIOA
#define ESC2_PWM_OUT_Pin GPIO_PIN_10
#define ESC2_PWM_OUT_GPIO_Port GPIOA
#define TELEMETRY_RX_UNUSED_Pin GPIO_PIN_7
#define TELEMETRY_RX_UNUSED_GPIO_Port GPIOB
