enyyaalark/px4-dual-motor-rpm-sync/tests/test_sync_controller.py

import pathlib
import subprocess
import tempfile
import unittest


ROOT = pathlib.Path(__file__).resolve().parents[1]
APP = ROOT / "firmware" / "stm32" / "App"


class SyncControllerTests(unittest.TestCase):
    @classmethod
    def setUpClass(cls):
        cls.temp_dir = tempfile.TemporaryDirectory()
        source = pathlib.Path(cls.temp_dir.name) / "sync_controller_test.cpp"
        source.write_text(
            r'''#include "sync_controller.hpp"
#include <cmath>

using rpm_sync::SyncController;
using rpm_sync::SyncControllerConfig;
using rpm_sync::reset;
using rpm_sync::step;

bool near(float actual, float expected) {
    return std::fabs(actual - expected) < 0.001F;
}

int main() {
    const SyncControllerConfig config{1.0F, 1.0F, 0.0F, 100.0F, 10.0F, 3.0F};
    const SyncControllerConfig deadband_config{1.0F, 1.0F, 5.0F, 100.0F, 10.0F, 3.0F};
    SyncController controller{};

    if (!near(step(controller, deadband_config, 101.0F, 100.0F, 0.1F, true), 0.0F)) return 1;
    reset(controller);
    if (!near(step(controller, config, 100.0F, 100.0F, 0.1F, true), 0.0F)) return 2;
    if (!near(step(controller, config, 200.0F, 100.0F, 1.0F, true), 10.0F)) return 3;
    if (!near(controller.integral, 0.0F)) return 4;
    if (!near(step(controller, config, 101.0F, 100.0F, 1.0F, true), 2.0F)) return 5;
    if (!near(controller.integral, 1.0F)) return 6;
    if (!near(step(controller, config, 100.0F, 200.0F, 1.0F, true), -10.0F)) return 7;
    if (!near(controller.integral, 1.0F)) return 8;
    if (!near(step(controller, config, 99.0F, 100.0F, 1.0F, true), 0.0F)) return 9;
    if (!near(controller.integral, 0.0F)) return 10;
    if (!near(step(controller, config, 200.0F, 100.0F, 0.0F, true), 0.0F)) return 11;
    if (!near(controller.integral, 0.0F)) return 12;
    controller.integral = 2.0F;
    if (!near(step(controller, config, 200.0F, 100.0F, 1.0F, false), 0.0F)) return 13;
    if (!near(controller.integral, 0.0F)) return 14;
    controller.integral = 2.0F;
    if (!near(step(controller, config, NAN, 100.0F, 1.0F, true), 0.0F)) return 15;
    if (!near(controller.integral, 0.0F)) return 16;
    const SyncControllerConfig negative_limits{1.0F, 1.0F, 0.0F, 100.0F, -10.0F, -3.0F};
    if (!near(step(controller, negative_limits, 101.0F, 100.0F, 1.0F, true), 2.0F)) return 17;
    if (!near(controller.integral, 1.0F)) return 18;
    const float unwind = step(controller, config, 199.0F, 200.0F, 1.0F, true);
    if (!near(unwind, -1.0F)) return 19;
    if (!near(controller.integral, 0.0F)) return 20;
    const SyncControllerConfig derivative_config{
        0.0F, 0.0F, 0.0F, 100.0F, 10.0F, 0.0F, 1.0F, 0.0F};
    SyncController derivative_controller{};
    if (!near(step(derivative_controller, derivative_config, 110.0F, 100.0F, 0.1F, true), 0.0F)) return 21;
    if (!near(step(derivative_controller, derivative_config, 120.0F, 100.0F, 0.1F, true), 10.0F)) return 22;
    if (!near(step(derivative_controller, derivative_config, 120.0F, 100.0F, 1.0F, false), 0.0F)) return 23;
    if (derivative_controller.filtered_error != 0.0F || derivative_controller.has_previous_error) return 24;
    const SyncControllerConfig filter_config{
        1.0F, 0.0F, 0.0F, 100.0F, 100.0F, 0.0F, 0.0F, 0.1F};
    SyncController filter_controller{};
    if (!near(step(filter_controller, filter_config, 120.0F, 100.0F, 0.1F, true), 10.0F)) return 25;
    if (!near(step(filter_controller, filter_config, 120.0F, 100.0F, 0.1F, true), 15.0F)) return 26;
    return 0;
}
'''
        )
        cls.binary = pathlib.Path(cls.temp_dir.name) / "sync_controller_test"
        subprocess.run(
            [
                "c++",
                "-std=c++17",
                "-Wall",
                "-Wextra",
                "-Werror",
                "-I",
                str(APP),
                str(source),
                str(APP / "sync_controller.cpp"),
                "-o",
                str(cls.binary),
            ],
            check=True,
            capture_output=True,
            text=True,
        )

    @classmethod
    def tearDownClass(cls):
        cls.temp_dir.cleanup()

    def test_deadband_limits_and_conditional_integration(self):
        result = subprocess.run([str(self.binary)], capture_output=True, text=True)
        self.assertEqual(result.returncode, 0, result.stderr)
