enyyaalark/px4-dual-motor-rpm-sync/(commit log)

2026-08-28 chore: initialize dual-motor RPM sync project
    [synthetic_rpm_log.csv]
2026-08-28 refactor: migrate STM32 application skeleton to C++17
2026-08-31 feat: complete STM32 LED and UART bring-up
    Squash merge for Issue #3 bring-up evidence and verification.
    [check_bringup_uart.py, check_stm32_toolchain.py, main.c, main.h, rpm_sync_bringup.ioc, test_check_bringup_uart.py, test_check_stm32_toolchain.py]
2026-08-31 feat: bound sync controller integration
    Squash merge for Issue #18 controller safeguards and boundary tests.
    [sync_controller.cpp, test_sync_controller.py]
2026-08-31 docs: add soldering checklist
2026-09-01 feat: validate hardware-independent RPM logic
    Closes #31. Parent #7 remains open for hardware capture, calibration, UART/CSV, and bench acceptance.
2026-09-01 feat: validate hardware-independent PWM input
    Closes #33. Parent #9 remains open for real PX4 output identification, hardware capture, dual-channel accuracy, and loss/out-of-range bench evidence.
2026-09-01 docs: record twin-pusher rig and battery
    Partial progress on #1. Battery capacity/electrical checks and PX4 configuration remain blockers for powertrain connection.
2026-09-01 feat: validate hardware-independent PWM output (#42)
2026-09-02 docs: add voltage interface table
2026-09-02 docs: add L1 hall trigger measurements to voltage interface table
2026-09-02 docs: record L1 hall trigger evidence for issue 4
2026-09-02 docs: respond to PR #51 review — baseline corrections and L1 evidence
    - Receiver identification correction: FS-iA10B -> FS-SR8 (2026-09-01 photo
    misread; user confirmed on 2026-09-02 the receiver was always FS-SR8).
    ANT protocol and PWM/PPM/i-BUS/s-BUS outputs cited to official FlySky
    product page and FS-SR8 user manual; actual output mode stays TBD.
    - Battery rating updated to 3S1P/11.1V/4000mAh/100C (user-confirmed
    capacity); removes unsupported 'LiPo' chemistry claim; chemistry,
    full-charge/measured voltage, connector and wire gauge stay TBD.
    - Both Raptor5 G071-35A ESCs confirmed with firmware ID Flycolor_Raptor_5.
    - Track L1 raw hall evidence in data/raw/2026-09-02/ via expl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
2026-09-02 fix: keep bypass selected for invalid corrected output
    [system_controller.cpp, test_system_controller.cpp]
2026-09-02 docs: respond to PR #54 review — bound Issue 5 evidence claims and add counts
2026-09-03 docs: mark SWD wiring validated
2026-09-03 docs: update STM32 SWD status
2026-09-03 feat: add dual hall timer capture firmware (#60)
2026-09-03 feat: expose hall capture telemetry (#61)
2026-09-03 test: add hall capture UART validator (#62)
2026-09-03 docs: record actual dual HC14 gate wiring (#63)
2026-09-03 docs: record Issue 6 dual Hall L1 crosstalk evidence (#65)
2026-09-03 docs: record SWD header solder status
2026-09-03 docs: bound Hall edge observation claim
2026-09-03 docs: propose STM32 timer pin allocation
2026-09-03 docs: record Issue 6 dual-Hall capture L1 UART verification
    PR #65 merged (e7b0802); capture firmware SWD-flashed/verified; PA0/PA1 dual-Hall UART capture (no-pulse/Hall1/Hall2/dual-restart) recorded with 4 raw evidence files under data/raw/2026-09-04/.
2026-09-04 feat: integrate Hall capture RPM evaluation (#66)
    * feat: integrate hall capture RPM evaluation
    * fix: keep RPM adapter host-checkable
    ---------
    [app_config.hpp, check_hall_capture_uart.py, hall_capture.c, hall_capture.h, main.c, rpm_evaluator.cpp, rpm_evaluator.h, test_check_hall_capture_uart.py]
2026-09-04 feat: add PPR calibration analysis tool (#67)
2026-09-04 feat: expose PWM output validation to HAL layer (#68)
2026-09-10 data: record Issue 8 PPR calibration (#71)
    [2026-09-10-ppr-calibration-input.csv, 2026-09-10-ppr-calibration-results.csv, 2026-09-10-ppr-calibration-sources.csv]
2026-09-10 config: add Issue 8 Hall monitor bounds (#72)
    [app_config.hpp, test_rpm_evaluator.cpp, test_stm32_capture_config.py]
2026-09-10 test: record dual Hall timeout evidence (#73)
2026-09-14 feat: integrate dual PX4 PWM input capture (#75)
    * feat: integrate dual PX4 PWM input capture
    * fix: timestamp PWM snapshots after capture
    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
    [app_config.hpp, check_pwm_input_uart.py, main.c, main.h, pwm_input_capture.c, pwm_input_capture.h, pwm_input_evaluator.cpp, pwm_input_evaluator.h]
2026-09-14 feat: configure TIM1 dual PWM output for Issue #10
    [main.c, main.h, rpm_sync_capture.ioc, test_stm32_capture_config.py]
2026-09-14 feat: configure PB2 bypass select GPIO for Issue #11
    [main.c, main.h, rpm_sync_capture.ioc, test_stm32_capture_config.py]
2026-09-15 fix: remap PX4 MAIN1 PWM capture from PA6 to PB4 (#78)
    [main.h, rpm_sync_capture.ioc, test_stm32_capture_config.py]
2026-09-15 fix: enforce dual base PWM validation and v2 bench bounds
    - update bench output bounds to 1060..1080 us
    - require MAIN1/MAIN2 valid, matched within 20 us, and >= 1060 us
    - pass both PWM snapshots through the controller adapter
    - add disarm/mismatch/single-timeout host tests
    - archive 2026-09-15 PX4 bench v2 parameter snapshot
    [app_config.hpp, main.c, system_controller.cpp, system_controller.hpp, system_controller_adapter.cpp, system_controller_adapter.h, test_pwm_output_adapter.cpp, test_system_controller.cpp]
2026-09-15 feat: improve sync controller damping and deadband handling
    Replace hard deadband zeroing with continuous deadband offset, and add optional first-order error filtering plus derivative damping. New kd and filter_tau defaults stay disabled pending bench Hall RPM calibration. Add host regression tests and update control docs.
    [app_config.hpp, bench_run.py, sync_controller.cpp, sync_controller.hpp, system_controller_adapter.cpp, test_bench_run.py, test_sync_controller.py]
2026-09-15 fix: validate damped sync control on bench
    [app_config.hpp, bench_run.py, sync_controller.cpp, test_bench_run.py]
